SHY10086332/lightguard-hardware/演示视频拍摄脚本_硬件版_完整.md

# 演示视频拍摄脚本 · 硬件版（完整分镜）

> 目标：**真实 MP4、3~5 分钟、≤300 MB、1920×1080**。
> 赛事明确**不要**纯 PPT 翻页 / 静态模拟画面 / 只讲概念的宣传片 —— 画面必须是**真机真跑**。
>
> 本脚本取代早先的简版（`演示视频拍摄脚本.md` 保留作历史记录）。
> 拍摄前先按 `硬件演示系统/现场演示检查单.md` 把设备过一遍。

---

## 〇、先定三个数（照这个录，事后不用返工）

| 项 | 建议值 | 说明 |
|---|---|---|
| 分辨率 / 帧率 | **1920×1080 / 25~30 fps** | 与已有软件视频一致（1920×1080/25） |
| 视频码率 | **8 Mbps**（H.264） | 4 分钟 ≈ 240 MB，安全落在 300 MB 内 |
| 音频 | **AAC 128 kbps**（旁白） | 有旁白更好懂；没条件就用字幕 |

**时长分配（总约 4 分 10 秒）**：

```
0:00 ─ 0:25  片头与全景（是什么）
0:25 ─ 1:05  接线讲解（灯带不能直连 GPIO、必须共地）
1:05 ─ 1:45  数据集生产线（打印标签 → 采集台自动裁切 → 记录表）
1:45 ─ 2:45  照度闭环（目标 300 lx → 9 秒收敛 → 扰动后自动恢复）
2:45 ─ 3:35  检测与反馈（合格品绿灯 / 缺陷品红灯+蜂鸣 / 差异图）
3:35 ─ 4:10  数据与结论 + 收尾
```

---

## 一、开拍前 15 分钟：准备单

### 1. 环境（最重要，写在最前面）

- [ ] **桌面清空**：把纸质材料、证件、成绩单、笔记全部收走 —— 镜头里绝不能出现个人信息
      （实测踩过：相机对着桌面时曾拍到过个人表格，**必须每次开拍前确认**）
- [ ] 电脑桌面整理干净：**关掉微信/QQ/网盘窗口**，浏览器**不要显示书签栏**
- [ ] 资源管理器窗口**不要出现在画面里**（里面有个人路径）
- [ ] 房间灯可以开着当补光，但**全程不要中途开关**（光照一变，检测基准就变了）

### 2. 设备与软件

- [ ] ESP32 插好（设备管理器出现 **CP200x / COM 口**），灯带 5V 适配器插好
- [ ] 先启动一次演示台确认能连上：
      `硬件演示系统\演示台\0_启动演示台.bat` → 点「自检」→ 全绿
- [ ] 参考图先设好（用 `标签打印_1_正常_normal.pdf` 打印并放好的那张合格品）
- [ ] 准备 2~3 张**缺陷纸**（断线 / 缺墨 / 污点 / 划痕 / 偏位，任选便于辨认的）
- [ ] 手机：横屏、1080p、**关闪光灯**、开飞行模式（避免来电打断）
- [ ] 录屏工具：**OBS**（免费、能同时录屏幕+摄像头）或 Win+G / Win+Alt+R
- [ ] 亮度设置：**25%**（相机不过曝区间），改完**等 10~15 秒**再拍第一张

### 3. 想清楚"要证明什么"

评委看的是**证据**，不是形容词。全片必须拍到这 8 个镜头（清单在下面第三节标了 ★）。

---

## 二、分镜表

### 片段 1｜片头与全景（0:00–0:25）

| 画面 | 操作 | 旁白（可照读） |
|---|---|---|
| 桌面全景：灯带 + ESP32 + BH1750 + 摄像头 + 电脑，镜头缓慢横移 | 无 | "这是一套给工业视觉质检用的硬件：它会**自己把光稳住**，再配一条**数据集生产线**，把采集、训练、检测串成闭环。" |
| 特写：亮起/熄灭的灯带 | 按 `LIGHT 0` → `LIGHT 25` | "灯带由 ESP32 的 PWM 控制，亮度可以精确到 1%。" |

★ 镜头 ①：灯带随命令变化（证明"真的可控"，不是摆拍）

### 片段 2｜接线讲解（0:25–1:05）

| 画面 | 操作 | 旁白 |
|---|---|---|
| 特写 BH1750 四根线 | 手指依次指 SCL→GPIO22、SDA→GPIO21、VCC→3V3、GND | "照度传感器走 I2C：SCL 接 22、SDA 接 21，**供电必须 3.3V**。" |
| 特写 MOS 模块 | 指 `IN+`、`IN-`、`OUT±` | "灯带**不能直接接 GPIO**，必须经 MOS 模块；ESP32 和灯带电源**必须共地**。" |
| 特写红绿 LED + 蜂鸣器 | 无 | "绿灯=合格、红灯=异常，异常还会短鸣一声。" |

★ 镜头 ②：串口回读（屏幕上显示 `PING` → `{"ok":true,"device":"LIGHTGUARD_ESP32"}`、`STATUS` 回照度）

### 片段 3｜数据集生产线（1:05–1:45）

| 画面 | 操作 | 旁白 |
|---|---|---|
| 打印好的 A4 标签纸（含 100mm 校验尺） | 拿尺子量一下页脚 | "标签 60×40 毫米，一页 18 个，页脚有 100 毫米校验尺，保证打印不被缩放。" |
| 采集台页面 | 双击 `05_数据集与标签设计\console\0_启动采集台.bat` | "采集台是我们自己写的独立小工具，不需要任何别的软件。" |
| **裁切预览图** | 按 Enter 采一次 → 鼠标划到预览图上 | "一帧里自动找出**完整**标签逐个裁成图片，被画面边缘裁掉的直接剔除；不同列亮度不同，可以只保留指定的列。" |
| `采集记录表.csv` | 打开 Excel/记事本 | "每张图都记着当时的**照度、亮度、时间**，数据可追溯。" |

★ 镜头 ③：裁切预览图（绿框=已保存、红框=已剔除，一眼看懂）
★ 镜头 ④：CSV 记录表（照度/亮度真实值）

### 片段 4｜照度闭环（1:45–2:45，全片重点）

| 画面 | 操作 | 旁白 |
|---|---|---|
| 演示台页面（左右分屏：左边相机、右边闭环面板） | 点「自检」→ 全绿 | "开拍前先自检：串口、照度、灯带、输出目录一次过。" |
| 目标填 `300`、容差 `20` → 点「开始稳光」 | 让曲线跑完（约 9 秒） | "设目标 300 勒克斯，上位机闭环开始工作：读照度 → 调亮度 → 再读，**9 秒收敛**。" |
| 曲线图特写 | 指着收敛点 | "实测从 25% 亮度起步、223 勒克斯，一步调到 31%、**283.3 勒克斯**，落在 ±20 容差内。" |
| **扰动演示**：用手遮一下灯带 / 手动把亮度改成 50% | 再点「开始稳光」 | "有人挡光、或者亮度被改乱了，它会**自动拉回目标照度** —— 这就是整套系统的稳光能力。" |

★ 镜头 ⑤：稳光曲线（黄虚线=目标，蓝线收敛）
★ 镜头 ⑥：扰动后自动恢复

**口径提醒（重要）**：上位机闭环是真机实测通过的（9.1 秒、283.3 lx）。
正式固件本身只提供 `LIGHT n` 手动调光，**闭环跑在上位机里** —— 就照实说，别说成"固件内置自动稳光"。

### 片段 5｜检测与反馈（2:45–3:35）

| 画面 | 操作 | 旁白 |
|---|---|---|
| 放**合格品** → 点「设为参考图」 | 页面提示"参考图已设置 709×472" | "先拿一张合格品当基准。" |
| 换**缺陷品** → 按 **Enter** | 页面出现 ⛔异常 + 差异图 | "换上有缺陷的标签，按回车 —— 系统判为**异常**，差异图直接标出**哪里不对**。" |
| **实物红灯特写** | 同时画面切到硬件 | "同时，硬件那侧**红灯亮起、蜂鸣器短鸣**。" |
| 换回合格品 → Enter | ✅正常 + 绿灯 | "换回合格品，判定为**正常**，绿灯亮。" |

★ 镜头 ⑦：红灯 + 蜂鸣（硬特写，务必拍到声音）
★ 镜头 ⑧：差异图（红色标出差异区域）

### 片段 6｜数据与结论 + 收尾（3:35–4:10）

| 画面 | 操作 | 旁白 |
|---|---|---|
| 验证记录页面滚动（实测数据表） | 无 | "所有结论都有原始记录：闭环 9 秒收敛；6 种缺陷图案 **6/6 判对**；PWM 从 1kHz 提到 8kHz 后，相机画面的频闪条纹从 8.8 灰阶降到 **0.5**。" |
| 安全说明特写（或字幕） | 关灯 | "固件默认亮度已改为 0%，**任何复位都不会自己亮灯**；收尾一律关灯。" |
| 结束卡（作品名 + 一句话） | 无 | "光稳智检 —— 让每一次检测，都在同一束光下。" |

---

## 三、拍摄技巧（能省掉一半返工）

1. **双机位最省事**：手机拍实物（横屏、固定位置），电脑用 **OBS** 录屏；
   剪辑时用**画中画**（屏幕 + 实物同框），评委一眼就能看懂"操作"和"硬件反应"是同步的。
2. **屏幕不要拍到反光**：屏幕亮度调高、别开闪光灯、斜 15° 拍。
3. **一次拍一段，别追求一条过**：每段拍 2 遍，剪辑挑好的。
4. **关键操作前停 2 秒**：比如点「开始稳光」之前停一下，方便剪辑时上字幕。
5. **声音**：旁白用手机贴近说，或事后配音；环境音（蜂鸣器）一定要收到。
6. **不要加速跳过等待**：等 10 秒收敛是**优点**，别加速掉；可以在字幕标"实时"。

---

## 四、剪辑与压缩

1. 用**剪映专业版**（免费）或 HandBrake（纯压缩）。
2. 字幕要点：给"照度 / 亮度 / 判定"这些数字**上字幕**，无声也能看懂。
3. 导出：**H.264 + AAC，1920×1080，8 Mbps** → 4 分钟约 240 MB。
4. 压缩核对（命令行核对时长与体积）：

```powershell
ffprobe -v error -show_entries format=duration,size,bit_rate -of default=nw=1 "光稳智检_硬件演示视频.mp4"
```

**必须落在这三个区间内**：时长 **180~300 秒**、大小 **≤300 MB**、分辨率 1920×1080。

---

## 五、匿名红线（逐条过一遍再交）

- [ ] 没有学校名称、校徽、指导教师姓名、成员姓名、学号、邮箱、报名编号
- [ ] 没有旧版含身份信息的 PPT / 旧比赛材料入镜
- [ ] 资源管理器窗口没有出现（里面可能带个人路径/文件名）
- [ ] 浏览器书签栏、收藏夹、天气定位没有入镜
- [ ] 微信 / QQ / 网盘等窗口没有入镜
- [ ] 文件名本身不含姓名/学号（建议就用 `光稳智检_硬件演示视频.mp4`）
- [ ] 视频属性/音轨里没有身份信息（导出后抽 3 帧看一眼、听 10 秒）

---

## 六、可以放心说的实测数字（有原始记录支撑）

| 说法 | 数据 | 记录位置 |
|---|---|---|
| 闭环收敛快 | 300±20 lx：25%→223.3 lx → 31%→**283.3 lx，9.1 秒** | 验证记录 §2.16.2 |
| 判定准确 | 6 种真实标签图案 **6/6 判对**，硬件指示每次跟随 | §2.16.3 / §2.17.1 |
| 频闪条纹已消除 | 行 σ 从 1 kHz 的 **8.85 → 0.50**（20%~35% 亮度） | §2.18 |
| 相机不过曝区间 | 20%~30%（纸面 215、对比度 170、过曝 0%） | §2.19.2 |
| 真机帧不误报 | 同场景两帧互比：差异 **0.000%**（阈值 0.25%） | §2.19.1 |
| 复位不会自己亮 | 固件默认亮度 **0%**，复位后回读 0% | §2.16.5 |

**不能说的**（会被追问）：
- ❌"固件内置自动稳光"（闭环在上位机）
- ❌"模型已经用自采数据训练完成"（训练要另做，说"数据生产线已就绪、训练流程已跑通"更准确）
- ❌"连续运行 30 分钟无异常"（除非真跑了那 30 分钟并留记录）
