SHY10086332/lightguard-hardware/硬件提交说明.md

# AIC AI+硬件提交说明

本目录是独立硬件演示材料，不修改已经提交的软件项目。

建议验收顺序：ESP32 Blink -> BH1750 测光 -> PWM 灯带 -> 摄像头采图 -> 软件检测 -> 红绿结果反馈。

云端不能控制本地 ESP32；硬件闭环应在本地电脑和纸箱检测箱中演示。

---

## 一、目录索引

| 位置 | 内容 | 状态 |
|---|---|---|
| `00_从采购到参赛_执行总表.md` | 从采购到参赛的执行总表 | 既有 |
| `01_ESP32固件/lightguard_esp32.ino` | **正式固件**：BH1750 + 灯带 + 红绿 RGB + 蜂鸣器，配合网页串口交互 | 既有 |
| `01_ESP32固件/固件说明.md` | 正式固件的引脚、串口、烧录说明 | 既有 |
| `01_ESP32固件/测试固件说明_硬件验证.md` | **新增**：五个验证固件的用途、编译结果、烧录方法、与正式固件的一致性约定 | 2026-10-04 |
| `01_ESP32固件/esp32_blink_test/` | **新增**：只验证板子本身（不接外设） | ✅ 已实测通过 |
| `01_ESP32固件/bh1750_test/` | **新增**：验证 BH1750 读照度（自带驱动 + I2C 扫描） | ✅ 已实测通过（见 §2.7） |
| `01_ESP32固件/light_pwm_test/` | **新增**：验证 PWM 调光，可切 BH1750 闭环 | ✅ 两种模式均编译通过，MODE=1 闭环已实测（见 §2.12） |
| `01_ESP32固件/indicator_test/` | **新增**：单独验证红绿指示与蜂鸣器（不接灯带/BH1750） | ✅ 已烧录实测通过（见 §2.11） |
| `01_ESP32固件/mos_polarity_probe/` | **新增**：MOS 模块 `IN±` 极性探针 | 已编译，**尚未动用**（T-202 仍待测） |
| `01_ESP32固件/flash_manual.ps1` | **新增**：一条命令完成"编译 + 等你按 BOOT + 烧录" | ✅ 预检实测通过 |
| `02_硬件安装与接线/硬件安装一步一步.md` | 安装步骤 | 既有 |
| `02_硬件安装与接线/安装现场核对单.md` | 现场核对单 | 既有 |
| `02_硬件安装与接线/接线图.md` | **新增**：BH1750 / MOS 模块 + 灯带 / RGB + 蜂鸣器 的接线图与安全事项 | 2026-10-04 |
| `02_硬件安装与接线/引脚表.md` | **新增**：引脚分配实测表 + 禁用引脚 + PWM 参数对照 | 2026-10-04 |
| `02_硬件安装与接线/接线速查卡_一页版.md` | **新增**：打印版一页速查（引脚/接线/烧录三步/上电顺序/红线/排错表） | 2026-10-06 |
| `03_采购清单/最低成本采购清单_标签质检纸箱版.md` | 采购清单 | 既有 |
| `04_硬件验证记录/hardware-test-log.md` | **新增**：逐项硬件测试记录（含 esptool 识别、四个镜像 Hash 校验、串口原始日志） | 2026-10-04 |
| `04_硬件验证记录/README.md` | **新增**：硬件调试库总说明（目录结构、测试顺序、环境、踩坑记录） | 2026-10-04 |
| `05_数据集与标签设计/数据集采集说明.md` | **新增**：数据集采集材料清单、一致性要求、采集流程、数量与划分建议 | 2026-10-07 |
| `05_数据集与标签设计/make_labels.ps1` | **新增**：标签图案生成器（正常 + 5 种缺陷，60×40mm，A4 打印页 18 个/页） | 2026-10-07 |
| `05_数据集与标签设计/capture_dataset.ps1` | **新增**：数据集自动采集脚本（固定亮度 → 等照度稳定 → 抓帧 → 自动命名 → 记录照度到 CSV） | 2026-10-07 |
| `05_数据集与标签设计/labels/` `print/` | **新增**：6 种标签图案 PNG + 6 张 A4 打印页（含裁切标记与 100mm 校验尺；单张标签 60mm × 40mm） | 2026-10-07 |
| `05_数据集与标签设计/*.bat` | **新增**：8 个一键脚本（1 个自检 + 6 个按类别采集 + 1 个网页采集） | 2026-10-08 |
| `05_数据集与标签设计/web/` | **新增**：网页采集小工具（本地 Node 服务 + 浏览器页面，实时预览、照度稳定判断、自动写 CSV） | 2026-10-08 |
| `05_数据集与标签设计/console/` | **新增**：**独立数据集采集台**（自带网页：相机预览 + 6 类计数 + 照度稳定判断 + 撤销 + 导出 zip；照度取服务端串口真值，退出自动关灯；**不依赖任何已有软件**） | 2026-10-08 ✅ 接口自测 12/12 |
| `05_数据集与标签设计/app_module/` | **新增**：把采集能力接进光稳智检软件的**增量模块**（后端 `dataset_manager.py` + 前端 `dataset.js` + 一键接入脚本 `apply_to_app.py` + `接入方案.md`；共用 `console\dataset_manager.py`） | 2026-10-08 ✅ 副本实测 12/12 |
| `硬件演示系统/演示台/` | **新增**：**上位机演示软件**（一个页面跑完闭环：自动稳光照度 → 拍照 → 判定 → 串口发 RESULT → 硬件绿灯/红灯+蜂鸣；含稳光曲线、差异图、判定记录 CSV；判定模块有独立自测）。同目录还有三个配套工具：`calibrate_lux.py`（照度标定并出报告，自动判断与相机不过曝区间是否冲突）、`light_off.py`（应急关灯，回读硬件确认）、`banding_check.py`（频闪条纹复测） | 2026-10-09 ✅ 真机联调通过（闭环 9.1s 收敛；6 种标签 6/6 判对且硬件指示跟随） |
| `硬件演示系统/现场演示检查单.md` | **新增**：一页版检查单（接线 → 上电 → 软件启动 → 演示四步 → 安全红线 → 故障速查），打印后逐项打勾 | 2026-10-09 |
| `硬件演示系统/最小硬件版_搭建与演示.md` | 最小硬件版的搭建与演示 | 既有 |
| `演示视频拍摄脚本.md` | 演示视频分镜与旁白脚本 | 既有 |

## 二、当前硬件验证进度（实测）

> 口径说明：下表只写**确实做过并留有记录**的项。闭环相关结论的适用范围单独标注，避免把验证固件的实测结果写成正式固件的功能。

| 验收项 | 结论 | 证据 |
|---|---|---|
| ESP32 能被电脑识别（COM 端口） | ✅ COM5 / Silicon Labs CP210x | `04_硬件验证记录/hardware-test-log.md` §2.1 |
| 芯片识别 | ✅ ESP32-D0WD-V3 rev v3.1，双核 240MHz，Flash 4MB | §2.2 |
| Blink 上传成功 | ✅ 四个镜像全部 `Hash of data verified` | §2.4 |
| 板载 LED 固定周期闪烁 | ✅ 500ms，串口同步 5 秒 10 行 | §2.5 |
| BH1750 能读照度 | ✅ I2C 0x23 识别成功，0～约1442 lx 动态响应正常 | §2.7 |
| PWM 能调节灯带 | ✅ 亮度随验证固件 `light_pwm_test` 的 `BRIGHTNESS:` 变化，人工目视确认。**正式固件 `lightguard_esp32.ino` 尚未编译/烧录**，其 `LIGHT n` 通道未实测 | §2.10 |
| 红绿指示逻辑正常 | ✅ 绿灯=正常 / 红灯=异常 / 异常短鸣，`indicator_test` 三轮自检人工确认 | §2.11 |
| MOS 模块 `IN±` 极性 | ⏳ **待测**（T-202）：已按 `IN+` 接 GPIO25、`IN-` 接 GND 完成 PWM 与闭环测试，但极性本身未用探针独立确认 | §2.10、§3 T-202 |
| **照度闭环（自动稳光）** | ✅ **算法实测通过**：三段阶跃平滑收敛，稳态偏差 ≤1.4%（见 §2.12）。⚠️ **验收点 900±30 lx 需先标定**：lx/% 斜率取决于 BH1750 相对灯带/样品的位置，记录里出现过 39（§2.10）与 28.5（§2.12）两个值，验收前须把 BH1750 固定到最终箱内标签位后复测一次并记录「达到 900 lx 所需亮度 %」。⚠️ **适用范围**：实测是在验证固件 `light_pwm_test`（MODE=1）与上位机 Python 控制器上完成的，**实测目标为 901 / 1472 / 2327 lx，未在 900 lx 验收点复测**；**正式固件 `lightguard_esp32.ino` 目前只支持手动 `LIGHT n`，闭环尚未移植进固件** | §2.12 |
| 8 kHz PWM 抑制频闪条纹 | ✅ **已复测（2026-10-09）**：同一方法（画面最平坦区域的逐行灰度均值标准差）下，行 σ 从 1 kHz 时的 8.85/8.78/8.80 降到 **0.50~0.94**（20%~35% 亮度），条纹基本消失。附带实测：这套光照下**相机自动曝光收敛慢**，≤10% 亮度不可靠（同一档位在不同等待时间下结论相反），**建议 20%~30%，且改完亮度等 5~7 秒再拍第一张** | §2.13、§2.18 |
| 摄像头稳定采图 / 纸箱光照均匀 / 自采标签数据 | ⏳ 未完成 | 见 §3 任务清单未勾选项 |
| **抓拍图片规范化** | ✅ 采集到的图片统一转成真 JPEG（RGB/质量 92）并**清除 EXIF 元数据**（数据集要交付，不该带相机元信息）；回归验证落盘文件 `format=JPEG`、`EXIF字段数=0` | §2.17.1 |
| **数据集采集台（独立版，推荐）** | ✅ **接口自测 12/12 通过**：首页 + 7 条接口（状态/采集/撤销/亮度/最近/缩略图/导出）、缺硬件时优雅降级（照度记空、`/api/light` 明确报 409 而不是假装成功）、目录穿越被拦、退出自动 `LIGHT 0` 关灯。**只依赖自己的固件串口协议，不含、也不改任何已有软件** | §2.15 |
| **采集台接入软件（增量模块，可选）** | ✅ **副本实测 12/12 通过**：4 条 `/api/dataset/*` 接口（状态/采集/撤销/导出）、页面注入、原有 4 条接口**零回归**；照度取服务端硬件状态。**原软件目录全程未被改动**（已验证：无 `_backup_*`、无新增文件），模块+一键脚本+回滚方案已备好 | §2.14 |
| **上位机演示软件 + 真机闭环联调** | ✅ **真机通过**：① 照度闭环 目标 300±20 lx → 25%(223.3) → 31%(**283.3 lx**)，**9.1 秒收敛**；② 6 种真实标签图案 **6/6 判对**，且每次判定都**通过串口改变了硬件的红绿指示**（不是只在网页显示）；③ 参数校验 400、未接硬件 409；④ 真机标定 **9.77 lx/每 1%**，据此发现 **900 lx 需 94.1% 亮度 → 与相机不过曝冲突**（见 §2.16.1，需决策）；⑤ 实测发现"强杀进程不关灯 → 板子复位回到默认 45%"的安全隐患，**已把固件默认亮度改为 0 并烧录验证**（复位后回读 `brightness=0`、照度 0 lx；调光回归 25%→222.5 lx 正常） | §2.16 |

## 三、三条最容易踩的坑（现场演示前务必确认）

1. **烧录必须手动按 BOOT**：这块板没有自动下载电路。
   手势＝**按住 BOOT 不放 → 按一下 EN/RST → 松开 BOOT**；或用 `flash_manual.ps1`（它会等你按）。
2. **灯带不能直接接 GPIO**，必须经 MOS 模块/驱动模块；且 **ESP32 的 GND 必须与灯带 5V 电源共地**。
3. **RGB 红绿不要接反**：`GPIO26 = 绿 = 正常`，`GPIO27 = 红 = 异常`。
   正式固件默认亮度已改为 **0%**（2026-10-09 烧录验证）：复位 / 拔插 USB 不会再自己亮。
   但**调光仍需显式发 `LIGHT n`**，收尾建议发一次 `LIGHT 0`（上位机软件连上与退出时都会自动发）。
