SHY10086332/lightguard-hardware/00_从采购到参赛_执行总表.md

# 光稳智检盒：从采购到参赛执行总表

本文件是整个项目的唯一总入口。按编号依次完成即可，不需要同时阅读所有代码文件。

## 0. 已确定的最终方案

| 项目 | 最终决定 |
|---|---|
| 参赛方向 | AI + 硬件创新 |
| 检测对象 | 普通A4纸上打印的工业标签 |
| AI方法 | 自采数据训练 `printed_label` PatchCore异常检测模型 |
| 硬件创新点 | BH1750测光 + ESP32闭环调节灯带 + AI检测 + RGB红绿状态/蜂鸣器反馈 |
| 结构 | 定制五层瓦楞纸箱暗箱，不做3D打印 |
| 标签尺寸 | A4纸上的 60mm × 40mm 标签（见 `05_数据集与标签设计/`），核心检测区约 50mm × 32mm |
| 纸箱内部尺寸 | 深490mm × 宽365mm × 高315mm（使用时确认是内尺寸） |
| 目标照度 | **900 ± 30 lux**（原定 450±20 lux 与实测标定不符，已按实测数据调整）。⚠️ **验收前必须先标定一次**：亮度→照度的斜率主要取决于 **BH1750 相对灯带/样品的位置**，不是灯带本身；记录里已出现 39 lx/%（§2.10，传感器贴近灯带）与 28.5 lx/%（§2.12，另一摆放位置）两个不同值。因此固定 BH1750 到**最终箱内标签位**后，从 10% 到 40% 逐档记录照度，把「达到 900 lx 所需亮度 %」写进日志，再据此确定验收点（按 28.5 或 39 lx/% 计算，900 lx 都落在 20%~35% 这一「相机不过曝」区间内，因此与数据集采集光照、演示光照可以做到三合一） |
| 不采用 | 机械臂、麦轮小车、传送带、树莓派、COCO、原 `bottle` 模型作为正式参赛模型 |

内置15类MVTec权重只用于软件功能演示。正式参赛实验统一选择自己训练生成的 `printed_label` 类别。

## 1. 文件阅读顺序

1. `00_从采购到参赛_执行总表.md`：先看本页，掌握全过程；
2. `最低成本采购清单_标签质检纸箱版.md`：照表搜索和下单；
3. `硬件安装一步一步.md`：照步骤摆放硬件、接线和验收；
4. `安装现场核对单.md`：安装时逐项打勾，核对安全停点和验收项目；
5. `最小硬件版_搭建与演示.md`：查看功能说明和比赛演示流程；
6. `firmware/README.md`：给ESP32烧录固件；
7. `自定义标签模型训练说明.md`：拍照、分数据集、训练和测试模型；
8. `05_数据集与标签设计/数据集采集说明.md`：标签图案生成、打印、按类别自动采集与照度记录；
9. `01_ESP32固件/测试固件说明_硬件验证.md`：五个验证固件的用途与烧录方法；
10. `README.md`：软件功能、启动方式和API技术说明（在 `aic AI+软件/软件项目源代码/01_可运行系统/` 下）。

## 2. 分阶段执行

### 阶段A：硬件未到货

- 双击 `start.bat`；
- 浏览器打开 `http://localhost:5051`；
- 使用“模拟硬件”演示测光、调光、检测和状态反馈流程；
- 双击 `01_创建标签数据目录.bat`，提前创建数据目录；
- 设计并打印 60mm × 40mm 的正常标签和不同缺陷版本（见 `05_数据集与标签设计/`）。

模拟模式用于开发和讲解，不能作为实物实验结果。

### 阶段B：下单

完整型号、搜索词、预算和避坑说明见：

```text
最低成本采购清单_标签质检纸箱版.md
```

预计核心硬件预算112～243元；已有摄像头、数据线或电源可以复用。价格以下单当天为准。

### 阶段C：纸箱搭建

1. 不在纸箱侧壁开进料口，先保留箱体完整；
2. 先量内尺寸，再把A4纸按定位线放在箱底：297mm边沿365mm方向，210mm边沿490mm方向；
3. 摄像头先用硬纸板临时固定在标签中心上方，量镜头最前端到纸面的距离并检查清晰度；箱高315mm时可从约305～315mm试拍，再按实物画面微调；
4. 摄像头画面、灯带和照度都验证且合盖画面确认后，才开最小镜头孔。USB插头通常不穿纸箱；若要开走线孔，按线缆粗细决定，不预设10mm；
5. 1米灯带先沿左右侧壁和后侧试摆，不要先裁剪或永久粘贴；先检查画面反光，再做标签中心与四角照度测量；
6. 需要柔光时才加描图纸，并与发光面留出间隙；
7. BH1750放在标签平面附近，感光面朝上、不被遮挡；ESP32、面包板、MOS模块和电源放箱外；
8. 用胶带封漏光处，并用定位线固定A4纸位置。

### 阶段D：接线与烧录

首次安装按 `硬件安装一步一步.md` 操作，并用 `安装现场核对单.md` 逐项确认；`firmware/README.md` 只用于烧录和查固件引脚，不可用旧总览中的示意去猜MOS端子。全部为5V/3.3V低压连接，不拆接220V市电。

第一次上电顺序：

1. 只连接ESP32和BH1750，验证照度读取；
2. 确认MOS准确型号、模块接线图、3.3V PWM兼容性、隔离/共地方式、灯带功率和适配器极性；任何一项不清楚时不接灯带5V电源；
3. 灯带电源保持拔掉，在网页切换到“ESP32串口实物”，选择正确COM口并连接，确认页面显示已连上实物；
4. 在实物模式把亮度设为0%并确认页面显示0%。**（2026-10-09 更新：正式固件默认亮度已由 45% 改为 0% 并烧录验证——复位后回读亮度 0%，重启 / 拔插 USB / 重连 COM 口都不会再让灯带自己亮，原先「每次重启前拔掉灯带 5V」的做法不再是必需。）**
5. 桌面短测正常后，先断开5V适配器，再断开ESP32 USB，将灯带临时放入箱内。复测前重新连接ESP32串口、设0%，再插5V适配器，然后做中心及四角照度检查和摄像头反光检查；
6. 全部位置确定后再开最小孔、固定硬件。RGB模块和有源蜂鸣器最后接，第一轮可以暂时不装；
7. 连续点亮10分钟并有人看管，确认灯带、纸箱和导线没有明显发热。

### 阶段E：制作和采集标签

建议准备：

- 正常标签：完整文字、边框和条码；
- 缺陷标签：缺字、遮挡、污损、断线、褪色、边缘缺损；
- 每种缺陷至少准备一张独立纸样；
- 相机、纸箱、灯光、焦距和A4定位线固定后再开始正式拍摄。

数据建议：

| 数据目录 | 内容 | 建议数量 |
|---|---|---:|
| `train/good` | 正常训练图 | ≥30张 |
| `calibration/good` | 独立正常校准图 | ≥6张 |
| `calibration/defect` | 独立缺陷校准图 | ≥6张 |
| `test/good` | 独立正常测试图 | ≥6张 |
| `test/defect` | 独立缺陷测试图 | ≥6张 |

同一照片不能进入两个目录；测试用实体纸样也不能出现在训练或校准环节。

### 阶段F：训练自己的模型

1. 双击 `01_创建标签数据目录.bat`；
2. 按目录放入照片；
3. 双击 `02_训练并测试标签模型.bat`；
4. 确认生成 `weights/printed_label.pth`；
5. 确认生成 `training_reports/printed_label_日期_时间.json`；
6. 重新启动网页并选择 `printed_label`。

这一步生成的是自己的正常特征记忆库和自己的校准阈值，不使用原来的 `bottle.pth`。

### 阶段G：对照实验

使用同一批独立测试纸样进行两组实验。纸箱合盖后外部遮光通常不会显著改变箱内照度；应使用可重复的灯带亮度变化或箱内遮光扰动，并在变化后再采图：

| 组别 | 灯光方式 | 其他条件 |
|---|---|---|
| 对照组 | 固定灯光亮度 | 相机、样品、纸箱不变 |
| 实验组 | BH1750 + ESP32自动稳光 | 相机、样品、纸箱不变 |

记录正常误报、缺陷漏报、F1、检测时间和照度波动。不要把训练集结果当成最终实验结果。

### 阶段H：参赛证据

建议至少保存：

- 纸箱内部结构照片；
- ESP32、BH1750、灯带和摄像头近照；
- 正常样品、各类缺陷样品照片；
- 自定义模型训练报告JSON；
- 对照组与自动稳光组结果表；
- 网页正常/异常检测截图；
- 一段 3～5 分钟（赛事要求时长）连续演示视频：展示灯带亮度扰动和照度恢复→正常检测→缺陷检测→红灯/蜂鸣器。

是否必须提交视频以当届比赛通知为准，但提前录制连续实物视频可以证明作品确实运行。

## 3. 最终完成标准

- [ ] 使用真实ESP32，而不是只用模拟模式；
- [ ] BH1750照度随遮挡和灯光变化；
- [ ] 自动稳光能进入目标照度 ±30 lux（验收点 900 lx，需先按最终 BH1750 位置标定「达到 900 lx 所需亮度 %」）；
- [ ] 相机连续采图20次无黑屏和严重虚焦；
- [ ] 生成自己的 `printed_label.pth`；
- [ ] 正常标签能够点亮绿灯；
- [ ] 缺陷标签能够点亮红灯并触发蜂鸣器；
- [ ] 有独立测试集结果，不只展示训练样本；
- [ ] 有固定灯光与自动稳光对照实验；
- [ ] 有照片、截图、报告和实物演示视频；
- [ ] 连续运行30分钟无程序崩溃和异常发热。

## 4. 当前暂时不做

- 自动传送和抓取；
- 多角度机械结构；
- 标签四角自动透视校正；
- PCB设计；
- 3D打印外壳；
- 手机App或云端平台；
- 多种实物类别同时训练。

这些功能不影响完成最基本、可参赛的AI+硬件作品。
