SHY10086332/lightguard-hardware/演示视频拍摄脚本.md

# AIC AI+硬件演示视频拍摄脚本

目标：真实 MP4，建议 3--5 分钟，最终文件不超过 300 MB。

> 📋 **拍摄前后照《现场演示检查单.md》走一遍**（接线 → 上电 → 软件启动 → 演示四步 → 安全红线 → 故障速查）。
> 里面每项都写了"看到什么才算对"，比临时回忆可靠。
> 上位机演示软件在 `硬件演示系统/演示台/`：双击 `0_启动演示台.bat`，
> 流程是「放合格品 → 设为参考图 → 稳光 → 换待检品按 Enter → 页面与硬件同时给出结果」。

## 镜头顺序

1. 0:00--0:20：展示纸箱检测箱、摄像头、灯带、ESP32、BH1750 和电脑。
2. 0:20--0:45：展示 ESP32、BH1750、灯带和电源接线，说明 5V 灯带电源与 ESP32 共地、灯带不能直接接 GPIO。
   （本方案 MOS 模块的控制端是 `IN+` / `IN-`，`IN-` 就是控制地，必须与 ESP32 的 GND 连通；换用其他型号时按其自身接线图接线。）
3. 0:45--1:10：打开软件，选择检测类别，加载模型。
4. 1:10--1:45：放入正常样本，点击采图/上传，展示“正常”结果、异常分数和热力图。
5. 1:45--2:30：更换缺陷样本，展示“异常”结果、热力图和叠加图。
6. 2:30--3:00：展示照度读数、灯光亮度调整和红绿状态反馈。
7. 3:00--3:35：上传多张图片，展示批量检测、历史记录和 CSV 导出。
8. 3:35--4:00：展示代码目录、硬件目录和项目在线展示页。

## 拍摄要求

- 画面必须来自真实运行过程，不能用 PPT 渲染图代替；
- 屏幕文字要清晰，避免拍到账号密码、学号等隐私；
- **不要拍到旧版（含学校名/指导教师/成员）的 PPT 或旧比赛材料**，也不要把资源管理器窗口里带个人路径或旧项目命名的文件名拍进去；
- **不要拍到个人浏览器的书签栏、收藏夹、天气定位等个人信息**；录制前清一个干净的桌面或用全屏软件窗口；
- 如果 ESP32 尚未完成实物闭环，应明确说“当前为模拟硬件模式”，不要声称已经实物联动；
- **口径提醒**：照度闭环目前只在验证固件 `light_pwm_test` 与上位机 Python 控制器上实测通过，正式固件 `lightguard_esp32.ino` 只有手动 `LIGHT n`。视频里不要说“固件已自动稳光”，可以说“闭环算法已在验证固件和上位机上跑通，固件版本还在移植”；
- 如果检测对象是瓶盖/标签，必须使用自采样本和自训练模型，不能把 `bottle` 类别称为瓶盖模型。
