SHY10086332/lightguard-hardware/演示视频拍摄脚本_软件版.md

# 演示视频拍摄脚本 · 软件版（光稳智检）

> 适用：**AIC 演示视频**与 **iCAN 演示视频**都可照这个拍/复用。
> 硬性要求：**MP4、3~5 分钟、≤300 MB、真实运行**，不许纯 PPT 或静态模拟。
>
> ⚠️ 现状：**已有一条成品** `光稳智检_演示视频.mp4`（**18.39 MB / 4 分 47 秒 / 1920×1080 / H.264+AAC**，
> 片头/页脚/资源管理器/浏览器 4 处已遮蔽，独立抽帧核验通过）。
> **如果赛事允许沿用，这条可以继续用**；本脚本用于「需要重拍」或「要补录硬件联动段落」的情况。
>
> ★ 注意：软件本体是**已提交的作品**，拍视频只做"运行与演示"，**不要改它的代码**。

---

## 〇、规格与时长分配（约 4 分 10 秒）

| 项 | 建议 |
|---|---|
| 分辨率 / 帧率 | 1920×1080 / 25 fps（与已有成品一致） |
| 码率 / 音频 | 8 Mbps H.264 + AAC 128 kbps |
| 录制方式 | **OBS 全屏录屏**（不要用手机拍屏幕，字会糊） |

```
0:00 ─ 0:25  片头：这是什么、解决什么问题
0:25 ─ 0:55  主界面导览 + 选择检测类别
0:55 ─ 2:00  核心演示：拍照检测（合格品 → 缺陷品）
2:00 ─ 2:40  批量检测 / 对比模式
2:40 ─ 3:20  历史记录与导出报告（CSV）
3:20 ─ 3:50  硬件联动（可选但很加分）
3:50 ─ 4:10  数据集与自定义训练闭环 + 收尾
```

---

## 一、开拍前准备

- [ ] **先启动软件**：双击 `01_可运行系统\start.bat`（或 `光稳智检_iCAN演示启动.bat`），
      浏览器打开 `http://localhost:5051`，确认标题与端口都对
- [ ] **模型就绪**：确认 `pretrained/` 与 `weights/` 到位、能正常选类别（否则检测会报 503）
- [ ] **素材就绪**：合格品图片 + 3~5 张缺陷图片（用真机拍的自采样本，别用公开数据集图）
- [ ] **桌面整理**：关掉微信/QQ/网盘；浏览器**隐藏书签栏**；资源管理器窗口不要入镜
- [ ] **窗口**：浏览器全屏（F11），分辨率 1920×1080，缩放 100%
- [ ] **录屏**：OBS 只录浏览器窗口（不要录整个桌面，避免带出其它窗口）
- [ ] 手机横屏备用（要拍"硬件灯/蜂鸣器"时用）

**匿名红线**：不出现学校名/Logo/指导教师/成员姓名/学号/邮箱/个人账号；桌面与路径里
不要出现个人姓名；文件名用 `光稳智检_演示视频.mp4`。

---

## 二、分镜表

### 片段 1｜片头（0:00–0:25）

| 画面 | 旁白 |
|---|---|
| 软件首页整体（卡片布局：模式 / 类别 / 硬件 / 上传 / 参数 / 统计） | "光稳智检是一套**工业视觉质检系统**：用正常样本训练，不需要收集缺陷样本，就能把异常挑出来。" |

### 片段 2｜主界面与类别（0:25–0:55）

| 画面 | 操作 | 旁白 |
|---|---|---|
| 类别卡片（多类别网格） | 鼠标点开一个类别 | "系统支持多类别切换，也可以自己采数据训练新类别（后面演示）。" |
| 硬件卡片（串口状态） | 鼠标移上去 | "硬件面板可以连接本地 ESP32：读照度、控灯带、把判定结果送到红绿指示灯。" |

### 片段 3｜核心：拍照检测（0:55–2:00）★ 全片重点

| 画面 | 操作 | 旁白 |
|---|---|---|
| 相机预览打开 | 点「打开摄像头」 | "现场用 USB 摄像头直接拍，不需要先存文件。" |
| 放**合格品** → 点「拍照检测」 | 结果：**正常**，显示异常分数与阈值 | "合格品判为正常，页面给出异常分数和判定阈值。" |
| 换**缺陷品** → 点「拍照检测」 | 结果：**异常**，显示热力图/差异区域 | "换上有缺陷的样品，判为**异常**，并标出异常区域。" |
| 阈值滑块 | 拖动阈值 → 重新检测 | "阈值可以现场调整，适应不同的严格程度。" |

★ 必须拍到的证据镜头：
1. 结果区同时出现**分数、阈值、判定**三个数（不是只有一个"通过"）
2. 缺陷位置可视化（热力图/差异图）
3. 同一张图在阈值调整前后判定变化

### 片段 4｜批量与对比（2:00–2:40）

| 画面 | 操作 | 旁白 |
|---|---|---|
| 选中多张图片 → 批量检测 | 出现逐张结果列表 | "产线上更多是批量场景，一次可以过一批图。" |
| 对比模式 | 两张图并排 + 分数对比 | "对比模式把正常和缺陷放在一起，方便看模型的分辨能力。" |

### 片段 5｜历史与报告（2:40–3:20）

| 画面 | 操作 | 旁白 |
|---|---|---|
| 历史记录列表 | 滚动 | "每次检测都留档：时间、类别、分数、判定。" |
| 点「导出报告」 | 打开 CSV（Excel 里中文不乱码） | "一键导出 CSV 报告，Excel 直接打开，可以作为质检台账。" |

### 片段 6｜硬件联动（3:20–3:50，有硬件就一定拍）

| 画面 | 操作 | 旁白 |
|---|---|---|
| 硬件卡片：选串口 → 点连接 | 状态变成"ESP32 实物" | "当硬件在线时，系统还能控制检测环境的光照。" |
| 设亮度 / 目标照度 | 实物灯带随之变化（画中画） | "目标照度下发到硬件，灯带自动调到对应亮度 —— **光照稳定，判定才稳定**。" |
| 拍一张 → 结果灯 | 合格绿灯 / 缺陷红灯+蜂鸣（画中画） | "判定结果直接送到硬件的红绿灯和蜂鸣器，现场不用看屏幕也知道结果。" |

### 片段 7｜数据集与自定义训练（3:50–4:10）

| 画面 | 操作 | 旁白 |
|---|---|---|
| 采集台页面（一图一标签） | 按一次采集 | "样本用我们自研的采集台采集：自动裁出每个标签，照度亮度逐张记录。" |
| 训练脚本执行 | 命令行跑 `train_custom_category.py`（可加速） | "采完的数据可以直接训练成新类别，形成**采集 → 训练 → 检测**的闭环。" |
| 结束卡 | 无 | "光稳智检：稳定光照，稳定判定。" |

---

## 三、录制与剪辑要点

1. **录屏用 OBS**：只录浏览器窗口；鼠标移动放慢、别乱晃。
2. **一段一录**：每个片段单独录，出错就重录那一段。
3. **数字要看得清**：录制前把浏览器缩放设为 100%，必要时后期**放大局部**（剪映"缩放/关键帧"）。
4. **等待要保留**：检测耗时、训练耗时**可以加速**，但要在画面角上标"×4 加速"。
5. **导出**：H.264 + AAC、1920×1080、8 Mbps；4 分钟约 240 MB。
6. **核对**：

```powershell
ffprobe -v error -show_entries format=duration,size -of default=nw=1 "光稳智检_演示视频.mp4"
```

必须满足 **180~300 秒**、**≤300 MB**。

---

## 四、可以放心说的（有实测/记录支撑）

- 本地 Flask + PyTorch 运行，**推理在本机**，不上传图片到云端
- 支持多类别、阈值可调、批量检测、历史留档、CSV 报告导出
- 用**正常样本**即可训练（PatchCore 异常检测思路），不需要缺陷样本
- 硬件侧：ESP32 读照度、控灯带、红绿指示 + 蜂鸣；闭环稳光 300±20 lx **9.1 秒收敛**
- 数据集侧：自研采集台 **一图一标签自动裁切**，逐张记录照度/亮度

## 五、不要说的

- ❌ 不要说"已部署在公网/在线可用"（除非真部署了并给出地址）
- ❌ 不要说"准确率 99%+"（除非有留出集上的真实评测数据）
- ❌ 不要把"硬件闭环"说成软件的一部分（是两套系统联动，口径要分清）
- ❌ 不要说"完全无人值守"（现场仍是本机运行 + 人工放样）
