SHY10086332/lightguard-hardware/05_数据集与标签设计/labels/label_faint.png

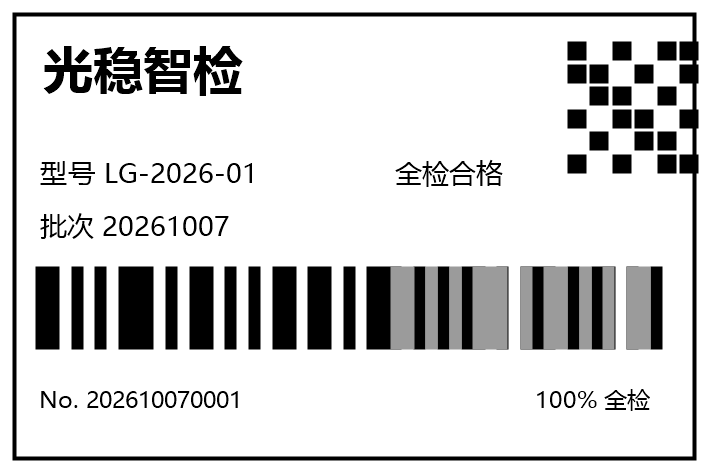
05_数据集与标签设计/labels/label_faint.png
