SHY10086332/lightguard-hardware/03_采购清单/最低成本采购清单_标签质检纸箱版.md

# 最低成本采购清单：A4标签质检纸箱版

适用方案：现有Windows电脑运行AI，定制瓦楞纸箱作为暗箱，普通A4纸打印正常/缺陷标签，ESP32完成测光、自动调光和结果反馈。

执行顺序和全项目文件导航见 `00_从采购到参赛_执行总表.md`。

不购买机械臂、麦轮小车、树莓派、显示屏、传送带和3D打印件。

## 一、下单顺序

建议只分三单，尽量减少运费：

1. 电子模块店：ESP32、BH1750、MOSFET模块、面包板、杜邦线、RGB灯模块、蜂鸣器；
2. 灯带店：5V灯带、5V电源、DC5521母座带线；
3. 摄像头店：UVC USB摄像头。
4. 纸箱店：按内尺寸定制五层瓦楞纸箱。

A4纸、胶带和描图纸尽量使用现有物品。

## 二、第一阶段必买清单

| 硬件 | 数量 | 作用 | 直接复制的搜索词 | 下单前必须确认 | 是否依赖精确尺寸 | 参考预算 |
|---|---:|---|---|---|---|---:|
| ESP32-WROOM-32开发板 | 1 | 读取照度、调节灯光、控制指示灯和蜂鸣器，并用USB串口和电脑通信 | `ESP32-WROOM-32 30针 Type-C CH340 已焊排针` | 成品开发板；已焊排针；Type-C口；能USB下载程序；不是单独裸模组 | 否 | 18～35元 |
| GY-302 BH1750照度模块 | 1 | 测量标签表面的实际照度，给自动稳光提供反馈 | `GY-302 BH1750 光照度传感器 已焊排针` | 已焊排针；3.3V可用；I2C接口 | 否 | 6～12元 |
| 720P UVC USB摄像头 | 1 | 从纸箱顶部拍摄标签，供AI检测；不必为1080P额外付费 | 低成本候选：`720P 55度3.8MM无畸变带外壳` | 确认是Windows可用UVC USB设备、支持彩色、附USB线；确认约30～32cm可清晰对焦；实际分辨率以电脑预览为准 | 先临时安装试拍，标签清晰完整后才定孔位 | 30～70元 |
| 5V COB中性光灯带 | 1米 | 给纸箱内部提供均匀、可调的检测光照 | 商品选项：`【5V 8mm宽 300灯/米】1米COB灯带 高亮款`，颜色选`中性光` | 单色两线；询问实际功率/电流；优先Ra≥90、约4000～5000K；无控制器；可裁剪；最好已焊红黑线 | 宽8mm，无需其他精确尺寸 | 12～25元 |
| PWM MOS管驱动模块 | 1 | ESP32不能直接带动灯带，此模块负责控制5V灯带亮度 | 首选：`XY-MOS 大功率MOS管模块 PWM调光调速 5-36V 3.3V触发`；也可：`YYMOS-1 PWM信号放大 MOS管驱动模块` | XY-MOS：负载5～36V、信号3.3～20V；YYMOS-1：输入输出3.3～24V、频率≤1kHz、负载≤3A | 否 | 5～15元 |
| 5V 4A稳压电源适配器 | 1 | 单独给灯带供电，避免烧坏ESP32 | `5V4A 电源适配器 DC5521` | 输出必须是5V直流；插头5.5×2.1mm；正规成品适配器 | 否 | 20～35元 |
| DC5521母座带红黑线 | 1 | 把5V适配器直接接到PWM模块，无需转接端子和焊接 | `DC5521 5.5×2.1 母座带线 红黑线 5A 30cm` | 必须是母座；内径2.1mm；红正黑负；线长约20～30cm；额定电流≥3A，优先5A款 | 否 | 3～8元 |
| 红黑并线/电源线 | 0或1米 | 仅在灯带自带线太短时延长灯带输出线 | `红黑并线 0.5平方 多股软线 1米` | 可先不买；灯带已焊线且长度够时不需要 | 按实际距离裁剪 | 0～8元 |
| MB-102 830孔面包板 | 1 | 固定和整理ESP32、传感器及指示模块的无焊接线路 | 商品选项：`MB-102 面包板165×55×10mm（1个）` | 只买单独面包板；不带电源模块、电池盒和双公头USB线 | 否 | 7～15元 |
| 杜邦线三种套装 | 1套 | 连接ESP32、BH1750和各小模块 | `杜邦线 公对公 公对母 母对母 20cm 三种套装` | 三种接头都包含；20cm左右 | 否 | 8～15元 |
| Type-C USB数据线 | 1 | 给ESP32供电、下载固件并和电脑串口通信 | `Type-C USB 数据线 可传数据 1米` | 必须能传数据，不能是仅充电线 | 否 | 5～10元 |
| 定制五层瓦楞纸箱 | 1 | 形成固定尺寸的遮光检测舱 | `五层瓦楞纸箱 定制尺寸 少量定做` | 向商家明确要求**内尺寸**490×365×315mm（深×宽×高）；普通开槽箱、无印刷；不要预开摄像头孔 | 是 | 按商家报价 |

第一阶段预算约 **112～243元**。同店合并购买、已有USB数据线或摄像头时还可以继续下降。价格只作预算上限参考，以下单当天为准。

## 三、建议同时购买，但可以稍后补

| 硬件/材料 | 数量 | 作用 | 搜索词 | 要确认的条件 | 参考预算 |
|---|---:|---|---|---|---:|
| 共阴RGB全彩LED模块 | 1 | 绿灯表示正常、红灯表示异常；蓝色通道第一版不用 | `RGB全彩LED模块 共阴 4针 自带限流电阻` | 公共端标`－`或GND；引脚包含R/G/B；自带限流电阻；已焊4针排针；用户所选5050共阴模块可用 | 2～6元 |
| 有源蜂鸣器模块 | 1 | 检测到缺陷时发出短提示音 | `有源蜂鸣器模块 3.3V 5V 高电平触发 S8050 三针` | 必须是有源、高电平触发；三针VCC/GND/IN；优先带三极管驱动 | 3～8元 |
| 描图纸/烘焙纸 | 1张 | 放在灯带前柔化光线，减少A4纸局部过曝 | `A4 描图纸 半透明` | 普通半透明、耐轻微发热即可 | 0～8元 |
| 黑色胶带、双面胶、扎带 | 各1 | 固定相机、灯带、传感器并封住纸箱漏光处 | `黑色布基胶带 强力双面胶 尼龙扎带` | 优先使用家里现有材料 | 0～20元 |
| A4普通打印纸 | 10～20张 | 制作正常标签和不同缺陷标签，用于自定义模型训练和测试 | `A4打印纸 70g 80g` | 普通纸即可，不需要250g卡纸 | 0～10元 |
| USB延长线 | 0或1 | 摄像头自带线够不到电脑时使用 | `USB2.0 延长线 1.5米` | 先量距离，够长就不买 | 0～15元 |

## 四、不要购买的东西

- 不买机械臂、麦轮底盘、传送带、树莓派、液晶屏和旋转平台；
- 不买3D打印外壳或相机架，先用纸箱、胶带和扎带；
- 不买`IRF520 MOSFET模块`，它不适合ESP32的3.3V控制信号；
- 不买标明负载输入最低为6V的隔离式D4184/LR7843模块，因为本方案灯带为5V；
- 不买12V或24V灯带，避免又要更换电源和驱动；
- 不买RGB、WS2812或带遥控器的灯带，本项目只需要单色两线白光灯带；
- 不买自动对焦会议摄像头作为首选，固定检测距离下手动调焦更稳定；
- 不买只有ESP32-WROOM-32字样的裸芯片模组，必须买带USB口的开发板；
- 不买未焊排针的BH1750，否则需要自己焊接。

## 五、需要的尺寸与不需要的尺寸

### 购买前必须知道

1. **纸箱内部深、宽、高**：实物按深490mm × 宽365mm × 高315mm使用；下单时必须向商家确认报的是内尺寸，而不是外尺寸。
2. **标签有效检测区尺寸**：A4上打印 60mm × 40mm 标签图案（见 `05_数据集与标签设计/`）；正式拍摄时相机只需完整覆盖该标签，A4纸本身不必完整进入画面。
3. **摄像头工作距离**：纸箱内高约315mm时，箱顶附近安装的镜头距纸面接近300mm。先临时安装实测；如果标签太小或失焦，再将摄像头下移。不要仅按商品标题中的55°推算视野。
4. **纸箱到电脑的距离**：决定摄像头线和ESP32数据线是否需要延长。
5. **纸箱开孔**：先完成临时试拍和走线，再开最小镜头孔。USB线孔按插头/线身实际大小决定；侧壁不切大孔。

### 现在不需要知道

- ESP32电路板精确长宽；
- BH1750电路板孔距；
- MOSFET模块安装孔距；
- RGB灯和蜂鸣器外壳尺寸。

原因是第一版全部用面包板、胶带和扎带固定，不打孔、不做PCB，也不做3D打印。只有以后要设计正式外壳时，才需要每个模块的精确尺寸和孔位。

## 六、给卖家的确认话术

购买MOSFET模块前发送：

```text
我要用ESP32的3.3V PWM信号，控制5V单色两线COB灯带，长度0.5～1米并调节亮度。
请提供准确型号和端子接线图，并确认模块支持5V负载、3.3V逻辑PWM、**8kHz** PWM（本项目实测用 8kHz：1kHz 会让相机画面出现频闪条纹）；PWM占空比增加时负载变亮。请说明输入有效电平、控制地接法、是否与负载侧隔离、额定电流，以及电源和灯带各接哪些端子。
```

部分XY-MOS商品会使用 `DC+ / DC- / OUT+ / OUT-` 和 `PWM（或TRIG）/ GND` 这些标识，但这不是所有MOS模块的通用端子顺序。不要只按外观、颜色或商品名接线；下单前让卖家确认准确型号、端子图、3.3V输入兼容性、PWM频率与有效电平、是否隔离/是否需要共地、5V负载接法及额定电流。到货后仍要核对实物丝印和接线图。

`YYMOS-1` 只有在卖家确认其具体版本满足以上参数时才可使用。若额定电流为3A，按余量选择灯带，并依据铭牌功率/电流核算；不同批次端子排列可能不同，接线前必须根据商品接线图或板上丝印核对输入、供电和负载端，不能只按端子位置猜测。

购买摄像头前发送：

```text
我要在Windows电脑的浏览器中使用，准备购买“720P 55度3.8MM无畸变带外壳”。请确认它是USB UVC摄像头，Windows免驱可用，附USB线，并能在约30～32厘米对标签对焦；也请说明实际支持的分辨率和焦距是否可调。
```

购买灯带前发送：

```text
我要购买“5V、8mm宽、300灯/米、1米高亮款”，颜色选中性光。
请问实际功率是多少W/米或电流是多少A/米？色温和显色指数是多少？
请确认是单色两线、可裁剪、不带控制器，最好发已焊红黑电源线的版本。
```

若卖家回复不超过10W/米（或不超过2A/米），可以使用完整1米；若超过10W/米，第一轮只使用0.5米，避免YYMOS-1长期接近3A上限。

## 七、到货后需要提供的信息

为了画最终纸箱内部布局，只需要拍照或测量下面四项：

1. 纸箱内部深 × 宽 × 高；
2. 摄像头正面、侧面以及支架照片；
3. 摄像头USB线长度；
4. A4标签实际打印区域的宽 × 高。

不需要使用游标卡尺，普通直尺测量到5mm精度就足够。
