SHY10086332/lightguard-hardware/05_数据集与标签设计/print/A4_brokenline.png

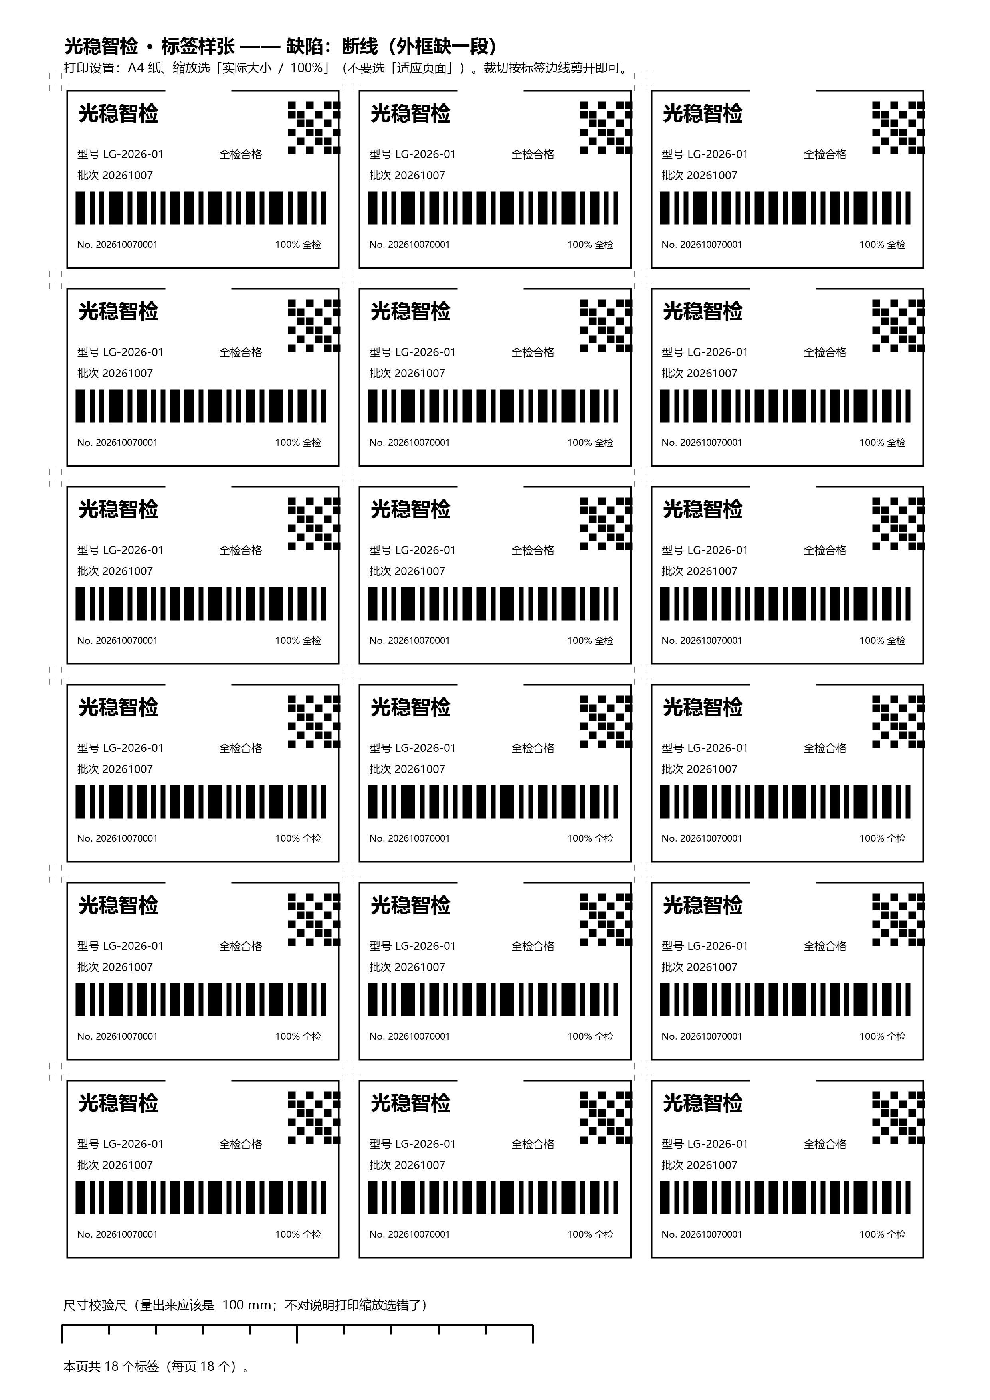
05_数据集与标签设计/print/A4_brokenline.png
