SHY10086332/lightguard-hardware/04_硬件验证记录/hardware-test-log.md

# 硬件测试记录（hardware-test-log）

记录每一次硬件验证的**原始证据**。规则：只写实测结果，不写"应该可以"。
每完成一项，在下面的总表和"最终任务清单"里同步打勾。

---

## 0. 环境基线（已固定，勿随意变更）

| 项 | 值 |
|---|---|
| 日期 | 2026-10-04 |
| 电脑 | Windows，Arduino IDE 2.x（`D:\arduino IDE\Arduino IDE.exe`） |
| 开发板支持包 | `esp32:esp32@3.3.12`（2026-10-04 安装，19 个压缩包 SHA-256 全通过） |
| 板型 / FQBN | ESP32 Dev Module / `esp32:esp32:esp32` |
| 串口 | COM5（Silicon Labs CP210x，VID_10C4 PID_EA60） |
| 速率 | 115200 8N1 |
| 命令行工具 | `arduino-cli 1.5.1`（IDE 自带）、`esptool v5.3.1` |

---

## 1. 测试总表

| 编号 | 项目 | 时间 | 结果 | 证据位置 |
|---|---|---|---|---|
| T-001 | 电脑识别串口设备 | 2026-10-04 23:10 | ✅ 通过 | §2.1 |
| T-002 | 芯片识别（esptool） | 2026-10-04 23:25 | ✅ 通过 | §2.2 |
| T-003 | 编译 esp32_blink_test | 2026-10-04 23:29 | ✅ 通过 | §2.3 |
| T-004 | 烧录 esp32_blink_test | 2026-10-04 23:32 | ✅ 通过 | §2.4 |
| T-005 | 板载 LED 闪烁 + 串口输出 | 2026-10-04 23:32 | ✅ 通过 | §2.5 |
| T-006 | 编译验证固件（仓库自检） | 2026-10-04 23:5x | ✅ 通过（当时 3 个，现共 5 个） | §2.6 |
| T-101 | BH1750 读照度 | 2026-10-05 00:26 | ✅ 通过 | §2.7 |
| T-201 | MOS 模块实物识别 | 2026-10-05 00:40 | ✅ 通过 | §2.8 |
| T-201b | 电源与灯带参数核对（电流核算） | 2026-10-06 16:20 | ✅ 通过 | §2.9 |
| T-202 | MOS 输入极性（IN+/IN-）确认 | — | ⏳ 待测 | 用 `mos_polarity_probe` |
| T-203 | PWM 固定阶梯调光 | 2026-10-06 21:0x | ✅ 通过（人工目视确认灯带随 PWM 变化） | §2.10 |
| T-204 | PWM 照度闭环 | 2026-10-07 13:2x | ✅ 通过（稳态偏差 ≤1.4%） | §2.12 |
| T-301 | 红/绿指示逻辑（含蜂鸣器） | 2026-10-07 13:1x | ✅ 通过 | §2.11 |
| T-401 | 摄像头稳定采图 | — | ⬜ 待测 | 接入主系统阶段 |
| T-402 | 纸箱光照均匀性 | — | ⬜ 待测 | — |
| T-403 | 正常样本判正常 | — | ⬜ 待测 | — |
| T-404 | 缺陷样本判异常 | — | ⬜ 待测 | — |
| T-405 | 串口协议跑通（Flask ↔ ESP32） | — | ⬜ 待测 | — |
| T-406 | 串口断开时降级为模拟演示 | — | ⬜ 待测 | — |

---

## 2. 详细记录

### 2.1 T-001 电脑识别串口设备 ✅

```
设备管理器 → 端口(COM 和 LPT)
Silicon Labs CP210x USB to UART Bridge (COM5)
InstanceId: USB\VID_10C4&PID_EA60\0001    Status: OK
```

结论：CP2102 驱动已装好，无需再装驱动。
（若换用 CH340 的板子，需另装 CH340 驱动，现象是"端口"里什么都不出现或出现带感叹号的未知设备。）

### 2.2 T-002 芯片识别 ✅

命令：
```
esptool --port COM5 --before no-reset flash-id
```
输出（关键行）：
```
Detecting chip type... ESP32
Chip type:          ESP32-D0WD-V3 (revision v3.1)
Features:           Wi-Fi, BT, Dual Core + LP Core, 240MHz, Vref calibration in eFuse
Crystal frequency:  40MHz
MAC:                20:9b:a9:97:b1:d4
Detected flash size: 4MB
Flash voltage set by a strapping pin: 3.3V
```

**同时确认了一个重要事实**：使用默认复位方式时报
`A fatal error occurred: Failed to connect to Espressif device: Wrong boot mode detected (0x13)!`
→ 说明**本板自动下载电路没有把 GPIO0 接到 DTR**，所以必须手动按 BOOT。
这不是板子坏了，是硬件设计如此（廉价 38pin 板常见）。

### 2.3 T-003 编译 ✅

```
Sketch uses 275112 bytes (20%) of program storage space. Maximum is 1310720 bytes.
Global variables use 22172 bytes (6%) of dynamic memory, leaving 305508 bytes for local variables.
```

首次编译曾失败：
```
Error during build: exec: "cmd": executable file not found in %PATH%
```
**根因**：系统机器级 PATH 与用户级 PATH 都缺少 `C:\Windows\System32`（用 `reg query` 原始读取确认）。
**处置**：已把 `C:\Windows\System32;C:\Windows;C:\Windows\System32\Wbem;C:\Windows\System32\WindowsPowerShell\v1.0;`
加回 HKLM 的 Path 最前面，并广播 `WM_SETTINGCHANGE`。
原值已导出备份为 `path-backup-machine-20261004-233654.txt`（存放在本机调试工作目录内，不入提交）。
**复验**：用"注册表重建的全新 PATH"再编译一次，`EXITCODE=0`。

### 2.4 T-004 烧录 ✅

手势：按住 BOOT → 按一下 EN → 松开 BOOT → 立即用 `--before no-reset` 烧录。
```
Writing 'bootloader.bin'  at 0x00001000 ... Wrote 24992 bytes ... Hash of data verified.
Writing 'partitions.bin'  at 0x00008000 ... Wrote 3072 bytes  ... Hash of data verified.
Writing 'boot_app0.bin'   at 0x0000e000 ... Wrote 8192 bytes  ... Hash of data verified.
Writing 'BlinkTest.ino.bin' at 0x00010000 ... Wrote 275264 bytes (518.5 kbit/s) ... Hash of data verified.
Hard resetting via RTS pin...
```
四个镜像全部 `Hash of data verified`（即写回校验通过）。

### 2.5 T-005 运行验证 ✅

串口 115200 抓到的完整启动日志：
```
ets Jul 29 2019 12:21:46
rst:0x1 (POWERON_RESET),boot:0x13 (SPI_FAST_FLASH_BOOT)
configsip: 0, SPIWP:0xee
mode:DIO, clock div:1
load:0x3fff0030,len:4876
entry 0x400805b4

===== ESP32 Blink Test =====
chip model : ESP32-D0WD-V3  rev 301  cores 2
cpu freq   : 240 MHz
flash size : 4 MB
sdk version: v5.5.5
mac        : D4:B1:97:A9:9B:20
led pin    : GPIO2
============================
LED ON
LED OFF
LED ON
LED OFF
```

交叉验证：固件读到的 MAC `D4:B1:97:A9:9B:20` 与 esptool 读到的 `20:9b:a9:97:b1:d4` 为同一串（字节序相反），互相印证读值真实。
节奏验证：5 秒内 10 行输出 = 每 500ms 一条，与 `BLINK_INTERVAL_MS` 一致。

### 2.6 T-006 仓库固件自检 ✅

下表三个固件在 `esp32:esp32:esp32` 下编译通过，且**不依赖任何第三方库**（BH1750 驱动自带），可直接在干净环境编译（`indicator_test`、`mos_polarity_probe` 见 `测试固件说明_硬件验证.md`）：

| 固件 | 编译结果 | Flash 占用 |
|---|---|---|
| `esp32_blink_test` | EXITCODE=0 | 275132 B (20%)（§2.3 原始日志里同一次构建写作 275112 B，两次记录略有差异，不影响结论） |
| `bh1750_test` | EXITCODE=0 | 297364 B (22%) |
| `light_pwm_test` (MODE=0 固定阶梯) | EXITCODE=0 | 307571 B (23%) |
| `light_pwm_test` (MODE=1 照度闭环) | EXITCODE=0 | 315239 B (24%) |

MODEL=1 比 MODE=0 多 7.6KB，说明 BH1750 闭环代码确实被编译进去了（不是空分支）。
切换模式命令：
```powershell
& $cli --config-file $cfg compile --fqbn esp32:esp32:esp32 `
      --build-property build.extra_flags=-DMODE=1 `
      ".\light_pwm_test"   # 本包内的固件目录（相对 01_ESP32固件 的位置）
```
（记住：**改完 MODE 必须重新编译+烧录**，板上跑的还是旧固件。）

---

### 2.7 T-101 BH1750 照度读取 ✅

**接线**（断电后接的，共 4 根线，`ADDR` 悬空）：

| BH1750 | ESP32 | 说明 |
|---|---|---|
| VCC | 3V3 | **不是 5V** |
| GND | GND | 共地 |
| SDA | GPIO21 | I2C 数据 |
| SCL | GPIO22 | I2C 时钟 |

**烧录**：`flash_manual.ps1 -Sketch .\bh1750_test`，按一次 BOOT 后自动完成，4 个镜像全部 `Hash of data verified`。

**启动日志（节选）**：
```
===== BH1750 Test =====
# chip ESP32-D0WD-V3   flash 4 MB   sdk v5.5.5
# i2c  SDA=GPIO21  SCL=GPIO22
# I2C 扫描结果：
#   发现设备 0x23
# 找到 BH1750：0x23
# 初始化完成，开始输出 LUX:<照度>
=======================
```

**90 秒连续采样（每 500ms 一条，原始时间戳）**：

| 时间 | 动作 | 读数 |
|---|---|---|
| 00:26:20 → 00:26:42 | 静置（室内光） | 稳定 **53.3 lx**（raw=64） |
| 00:26:43 → 00:26:55 | 手掌完全捂住感光面 | 跌到 **0.0 lx**（raw=64 → 11 → 0） |
| 00:26:56 → 00:27:15 | 手机手电筒照射 | 峰值 **raw=1730**，按固件公式 `照度 = raw / 1.2` 换算为 **1441.7 lx** |
| 00:27:16 → 00:27:26 | 移开手电 | 回落 184.2 → 104.2 → 51.7 lx |
| 00:27:27 → 00:27:50 | 静置 | 稳定回 **50.8 lx** |

结论：
- 动态范围约 **0 ~ 1441.7 lx（约 27 倍）**，捂住/照光/移开三个动作都有明确且平滑的响应，无跳变、无卡死、无掉线；
- 读数噪声小（静置时同一 raw 值连续出现数十次），说明 I2C 通信质量良好（杜邦线长度短、上拉正常）；
- **通过标准满足**：遮住读数明显变化 ✅
- ⚠️ 原记录把该峰值写作 1549.2 lx，与同行的 raw=1730 不自洽（1730 / 1.2 = 1441.7），已按固件实际公式更正。

**这一步同时确认的事**：`bh1750_test` 不需要任何第三方库即可编译运行（驱动自带），
所以后续若只想快速验证硬件，不必先去库管理器装 `BH1750 by Christopher Laws`
（该库仅正式固件 `lightguard_esp32.ino` 需要）。

---

### 2.8 T-201 MOS 模块实物识别 ✅

**背景**：需要确认手上这块模块是不是"能被 ESP32 控制的 MOS 管 PWM 驱动模块"，
而不是"手调 PWM 调速器"（后者有旋钮、没有信号输入脚，ESP32 无法控制）。

**核对方式**：用户实拍照片（正/反面各数张）+ 用户现场读丝印。

**核对结论** ✅：

| 核对项 | 结果 |
|---|---|
| 外形 | 蓝色 PCB，**4 位螺丝端子 + 2 位螺丝端子**，**无旋钮** |
| 型号字样 | 板上可读丝印含 `MOS-1`（与清单中 XY-MOS 同类） |
| 4 位端子丝印 | `DC-` `DC+` `OUT+` `OUT-`（电源进 / 负载出） |
| 2 位端子丝印 | `IN+` `IN-`（信号输入） |
| 判断 | **是标准 MOS 管 PWM 驱动模块，可用** ✅（不是旋钮调速器） |

**注意点**：`IN+` / `IN-` 的丝印是竖排小字，用户报告的顺序与照片读数存在差异，
**因此不靠"看丝印"决定极性**，改用 `mos_polarity_probe` 固件做电气自检（见 T-202）。
把 GPIO25 接到 `IN-` 等于短路到地，可能烧引脚，这一步不做赌博式判断。

**兼容性核对**：模块资料标称输入 5~36V、信号 3.3~20V、PWM 0~20kHz；
正式固件用 8kHz/8 位、本验证库同样 8kHz/8 位（2026-10-07 由 1kHz 提高）—— 均在允许范围内。

---

### 2.9 T-201b 电源与灯带参数核对（插 5V 之前的必做核算）✅

**依据**：用户提供的两张实物照片（适配器铭牌、灯带包装标签），2026-10-06 核对。

| 器件 | 照片上的原始信息 | 结论 |
|---|---|---|
| 5V 适配器 | `MODEL:0540`；`INPUT:AC100-240V 50/60Hz`；**`OUTPUT: 5V ⎓ 4A`**；极性符号为**中心正、外负** | 5V 4A = **20W**，满足需求 |
| 5V 灯带 | `【5V 8mm 300灯/米】1米COB灯带[高亮款] 中性光`，1 件 | 单色两线 COB，1m，中性光 ≈4000~4500K（适合检测箱） |

**电流核算**：

```
适配器可供 ：5V × 4A = 20 W
灯带预估   ：5V COB 300灯/米 高亮款 ≈ 8~12 W/米 → 1.6~2.4 A（标签未标功率，取同类经验值）
余量       ：4 A ÷ 2.4 A ≈ 1.67 倍   → 1 米整条可直接使用，无需截短
MOS 模块   ：双 MOS 设计，Rds(on) 按 10~20mΩ 估，2~3A 时发热约 0.1 W，无需散热片
```

**判定**：✅ 允许接入整条 1 米灯带。**灯带实际功率是唯一未知量**，因此首次点亮用现象兜底：

| 现象 | 含义 | 处理 |
|---|---|---|
| 模块只是温热 | 正常 | 继续 |
| 模块明显烫手（不能持续接触 3 秒） | 电流偏大 | 拔 5V，限制到 ≤50% 亮度，或只接半条 |
| 亮度忽明忽暗 / ESP32 复位 | 电源被拉低 | 拔 5V，减小负载 |

**已预判的已知现象**：5V 灯带 1 米存在**沿线压降**（远端偏暗），属正常物理现象；
若影响"5 点照度均匀性"测量，可改为**灯带两端同时接电源线**（双端供电）。

**待确认项**：DC5521 母座带线的**红/黑线对应关系**（一般红=中心正极、黑=外负）。
接反会让 MOS 模块承受反压，因此第一次上电前应目视确认线色与适配器极性符号一致。

---

### 2.10 T-203 / T-204 灯带 PWM 与照度闭环（2026-10-06 实测）

**接线**：`适配器红→DC+`、`黑→DC-`、`灯带红→OUT+`、`黑→OUT-`、`GPIO25→IN+`、`GND→IN-`（DC5512 母座线接适配器）。
固件：`light_pwm_test`，PWM **8 kHz / 8 位**（2026-10-07 由 1 kHz 提高），GPIO25。

#### T-203 固定阶梯调光 ✅

安全启动固件启动后亮度锁定 0%，发送命令后逐档升亮，**人工目视确认灯带亮度随 PWM 同步变化**
（`BRIGHTNESS:` 值在 0/25/50/75/100 之间变化，灯带对应变亮变暗）。
→ **PWM 调光链路（GPIO25 → MOS 模块 → 灯带）验证通过**，且 5V 适配器与 ESP32 共地成立（通过 `IN-`）。

#### T-204 照度闭环 🔶 链路通、参数需标定

**实测数据（命令 `T:0`+`A` 使亮度压到 0，`B:100` 手动锁定全亮）**：

| 状态 | BH1750 读数 | 亮度 |
|---|---|---|
| 环境（灯带灭） | **49.2 lx** | 0% |
| 灯带全亮 | **3951.7 lx** | 100% |
| 灯带贡献 | **+3902.5 lx** | — |

→ **BH1750 能看到灯带的光，灯带能被 PWM 控制，闭环的两个方向都通。**

**发现的问题（真实工程问题，已定位并修正）**：闭环进入后亮度在 0% 与 100% 之间**来回跳**：

```
BRIGHTNESS: 100 → 0 → 0 → 0 → 100 → 0 → 0 → 0 → 100 → 88 → 85 → 84 → 17 → 0 …
```

**根因**：按第一次标定的增益估算 —— `3902.5 lx ÷ 100% ≈ 39 lx / 每 1% 亮度`。
> ⚠️ 这只是**第一次标定**（传感器贴近灯带）；后来在 §2.12 重新标定为 0% → 45.8 lx、100% → 2897.5 lx（≈28.5 lx/%）。
> **lx/% 与被 BH1750 摆放位置强相关**，标定与验收请以最终箱内位置的复测值为准。
原固件比例系数 `KP = 0.06` ⇒ **环路增益 = 0.06 × 39 = 2.34 ≫ 1**，比例控制必然振荡。

**修正（第一轮迭代）**：

| 参数 | 原值 | 新值 | 理由 |
|---|---|---|---|
| `KP` | 0.06 | **0.0025** | 按第一次标定 39 lx/% 环路增益 ≈0.098（按最终标定 28.5 lx/% 约 0.071） |
| `MAX_STEP_PCT` | 无（一步到位） | **8** | 单周期最多调 8%，防止猛冲 |
| 死区 | 无 | 第一轮 **15 lx** → 最终改为**按目标值的 ±2%**（代码中为 `DEADBAND_PCT = 2.0f`） | 进入死区就不动，消除目标点附近抖动 |

另外修正了 MODE 1 的一个交互问题：手动亮度（`B:n`）下也应持续读照度（只读不调），
方便后续标定；MODE 0 下 `B:n` 仍不触发阶梯。

**下一步（已完成）**：烧入标定后的固件后复测，三段阶跃平滑收敛、稳态偏差 ≤1.4%，结论见 §2.12。
抗干扰（遮挡/手电筒扰动）测试**尚未开展**。

---

### 2.11 T-301 红绿指示灯 + 有源蜂鸣器 ✅（2026-10-07）

**固件**：`indicator_test`（引脚与正式固件 **相同**：GPIO26 绿 / GPIO27 红 / GPIO32 蜂鸣器）。
⚠️ **串口协议并不相同**：`PING` 回 `LIGHTGUARD_INDICATOR`，只实现自检 `T` 与 `RESULT`，
不实现 `STATUS` / `LIGHT`，返回也不是正式固件的完整 JSON → **不能用网页直接连它**，只用于离线点亮验证。

**接线**（全部经面包板电源轨做总线）：

| 模块 | 引脚 | 接到 |
|---|---|---|
| 共阴 RGB | `G` | ESP32 **GPIO26**（绿灯 = 正常） |
| 共阴 RGB | `R` | ESP32 **GPIO27**（红灯 = 异常） |
| 共阴 RGB | `-` | 面包板**蓝轨**（GND 总线） |
| 共阴 RGB | `B` | 不接 |
| 有源蜂鸣器 | `VCC` | 面包板**红轨**（3V3 总线） |
| 有源蜂鸣器 | `GND` | 面包板**蓝轨** |
| 有源蜂鸣器 | `IN` | ESP32 **GPIO32** |

**面包板用法**：只借左下段的两条电源轨做总线 —— 蓝轨（GND）汇 5 根线，红轨（3V3）汇 3 根线；
中间孔区不使用；ESP32 / BH1750 / MOS 模块都平放在桌面，不插板。
（注意：MB-102 的电源轨**中间断开**，上下段互不相通，所有线必须插在同一段内。）

**测试方法**：连发 3 次自检命令 `T`，每轮为「绿灯 2s → 红灯 2s + 短鸣 → 全灭」。
串口 3 次均返回 `{"ok":true,"selftest":"done"}`；**人工目视 + 听觉确认**三轮表现完全一致且正确。

**结论**：
- 三个输出通道（GPIO26 / GPIO27 / GPIO32）全部工作正常 ✅
- 实物模块为**共阴型**、蜂鸣器为**有源型（高电平触发）**，与代码假设一致，无需改参数
- 安全启动有效：上电时全部熄灭，只有收到命令才动作

---

### 2.12 T-204 照度闭环 ✅（2026-10-07，参数两轮迭代后通过）

**目标**：让 ESP32 自动调节灯带亮度，把 BH1750 处的照度**锁定在设定值**上
（这是"照度稳定后再拍照"的前提，也是自动适应不同箱体/环境光的关键）。

**被控对象实测**：灯带 0% → 45.8 lx（环境），100% → 2897.5 lx
⇒ 增益约 **28.5 lx / 每 1% 亮度**（不同摆放位置会变，所以参数要按量级标定）。

> ⚠️ **口径提醒（验收必读）**：这个 28.5 lx/% 只对**这一次的 BH1750 摆放位置**成立。
> §2.10 第一次标定时传感器贴近灯带，测得约 **39 lx/%**；传感器离得越远，斜率越小。
> 因此 **lx/% 是"位置相关"的**：验收/采集前必须把 BH1750 固定到**最终箱内标签位**再标定一次，
> 记录「达到 900 lx 所需亮度 %」，再据此确定验收点（900±30 lx）。

**参数迭代过程（真实调试记录）**：

| 版本 | 参数 | 现象 | 诊断 |
|---|---|---|---|
| v1 | `KP=0.06` | 亮度在 **0%↔100% 来回跳** | 环路增益 = 0.06×39 ≈ **2.34 ≫ 1**，比例控制必然振荡 |
| v2 | `KP=0.0025` + 单步限幅 8% + 死区 15 lx | 振荡消失、轨迹平滑，但**停在离目标 20% 处** | 误差 326 lx × 0.0025 = **0.8%，被 `(int)` 取整成 0** → 永远差一口气 |
| **v3（通过）** | `KP=0.0025` + **最小步长 1%** + 死区 **±2%×目标** | 平滑收敛，稳态偏差 ≤1.4% | — |

**v3 实测（三段目标阶跃）**：

| 段 | 目标 | 亮度轨迹（节选） | 末态照度 | 偏差 |
|---|---|---|---|---|
| 1 | 1472 lx | 97 → 94 → 91 → … → 54 → 53 | **1473.3 lx** | **+1 lx（+0.1%）** |
| 2 | 2327 lx | 55 → 57 → 58 → … → 83 → 84 | **2293.3 lx** | **−34 lx（−1.4%）** |
| 3 | 901 lx | 81 → 78 → 75 → … → 33 → 32 | **888.3 lx** | **−13 lx（−1.4%）** |

**结论**：
- ✅ 三段阶跃全部平滑收敛，**无振荡、无过冲**，稳态偏差 ≤1.4%
- ✅ 精度上限由亮度分辨率决定：1% 亮度 ≈ 28.5 lx，因此闭环精度约 **±1~2%**，与正式固件的 1% 亮度分辨率同量级
- ✅ 死区按目标值百分比自适应，换到箱内不同照度区间仍适用
- ⚠️ **适用范围**：以上结论来自**验证固件 `light_pwm_test`（MODE=1）与上位机 Python 控制器**；
  正式固件 `lightguard_esp32.ino` 目前只支持手动 `LIGHT n`，闭环尚未移植（见下面"给正式固件的建议"）
- ⚠️ 实测目标为 901 / 1472 / 2327 lx，**未在 900 lx 验收点复测**

**给正式固件的建议**：把这套参数（`KP=0.0025`、最小步长 1%、死区 ±2%）移植到
`lightguard_esp32.ino`，替换目前"只能手动设亮度（`LIGHT n`）"的做法，
即可实现"照度稳定后再拍照"的自动稳光闭环。

---

### 2.13 T-501 相机画面 PWM 频闪条纹与消除（2026-10-07）

**现象**：接入 USB 摄像头（`USB Camera`，VID_0BDA/PID_D576）后，画面出现**固定横向明暗条纹**。

**量化方法**：从画面纸面空白区取 80px 宽竖条 → 逐行求灰度均值 → 统计波动标准差
（`ffmpeg -vf "crop=80:1080:950:0,format=gray" -f rawvideo` + PowerShell 逐行统计）。

| 帧 | 平均灰度 | 最暗 | 最亮 | **波动标准差** |
|---|---|---|---|---|
| b25-02 | 168.7 | 117.6 | 182.7 | **8.85** |
| b25-03 | 168.6 | 116.6 | 183.2 | **8.78** |
| b25-04 | 168.6 | 127.5 | 183.5 | **8.80** |

**三帧几乎相同** → 不是随机噪声，而是**固定相位图案**（相机曝光与 PWM 锁相），
符合"PWM 调光 × 卷帘快门"的频闪条纹特征；严重程度 ≈ 3.5% 满量程。

**根因**：灯带 PWM 为 **1 kHz**（周期 1 ms），画面较亮时相机选择**很短的曝光时间**，
卷帘快门逐行曝光 → 每行看到的 PWM 相位不同 → 固定横向条纹。

**修正**：PWM 频率 **1 kHz → 8 kHz**（`lightguard_esp32.ino` 与 `light_pwm_test` 同步修改）。
> ⚠️ **待复测**：上表三帧标准差（8.85 / 8.78 / 8.80）是**改频率之前**、1 kHz 下测得的数据。
> 改成 8 kHz 后**还没有重新采集逐帧数据**，"条纹幅度大幅下降"目前只是按原理推断，须在实机上复测后才能写结论。
原理：8 kHz 周期 125 µs，相机单行曝光跨越多个 PWM 周期被平均掉，条纹幅度大幅下降。
本模块标称 0~20 kHz，8 kHz 在允许范围内；**换用 ≤1 kHz 的模块须改回 1 kHz**。

**同步更新**：`固件说明.md`、`测试固件说明_硬件验证.md`、`引脚表.md`、`接线图.md`、`接线速查卡_一页版.md`。

**★ 工程约定**：**训练数据、测试数据、演示视频必须在同一套光照设置（同一 PWM 频率）下采集**，
否则模型输入分布不一致、准确率会下降。最终频率一经确定不要随意更改。

**同时确认的摄像头信息**：

| 项 | 值 |
|---|---|
| 设备名 | `USB Camera`（VID_0BDA / PID_D576），免驱 UVC |
| 实测分辨率 | 1920 × 1080 |
| 抓帧方式 | `ffmpeg -f dshow -i "video=USB Camera"`（本机已验证） |
| 25% 亮度成像 | **文字清晰可辨认**（能读出姓名、身份证号、手写内容、签字日期）✅ |
| 100% 亮度成像 | **过曝**，纸面一片白、文字被冲掉 ❌ |
| 结论 | 箱内工作亮度应取 **20%~35%**（≈300~600 lx）；100% 不可用 |

### 2.14 T-601 数据集采集台接入光稳智检（2026-10-08，离线副本实测）✅

**目的**：把"现场采集数据集"这一步做进现有 Flask 软件（形成 采集 → 训练 → 检测 → 报告 的闭环），
且**不能碰已经提交的检测逻辑**。

**方法（关键）**：不直接改原软件，而是把 `01_可运行系统` 整目录复制到一份临时副本
（与任何提交目录无关的独立文件夹），在副本上用 `apply_to_app.py` 应用改动，
把副本**真起服务**（`PORT=5098` 避开原端口），逐一打接口验证。原软件一次都没被写过。

**这一步抓出 3 个只看代码绝对发现不了的坑**：

| # | 问题 | 现象 | 根因 | 修正 |
|---|---|---|---|---|
| 1 | **插入点错了** | 改完访问 `/api/dataset/status` 返回 **404** | 代码追加在文件**最末尾**，而末尾在 `if __name__ == '__main__': app.run(...)` **之后**；`app.run()` 阻塞不返回 → 后面的模块级代码（含路由注册）**永远执行不到** | 必须插在 `if __name__ == '__main__':` **之前** |
| 2 | 控制台花符号崩 | 装完打印最后一行时抛 `UnicodeEncodeError: 'gbk' codec can't encode '\u2714'` | Windows 控制台默认 cp936，编不出 `✔ ⚠ ✗` | 输出改用 `[OK] [!] [x]`，并给 `print` 加编码兜底 |
| 3 | CSV 中英混排 | `normal` 行缺陷列写「无」（中文），`scratch` 行写 `scratch`（英文） | 代码里 `defect = cls`（英文 key） | 改成写中文标签（划痕/缺墨…），列内语言统一；「类别」列仍是英文 key（与目录名一致） |

**接口自测结果：12 项全通过**

| # | 测试 | 期望 | 实测 |
|---|---|---|---|
| 1 | `GET /api/dataset/status` | 6 个类别、各类计数 | ✅ `classes=6`，`per_class` 全 0 |
| 2 | 首页注入 | 页面含 `js/dataset.js` | ✅ HTTP 200，且 `js/main.js` 仍在 |
| 3 | `POST /api/dataset/capture` | 落盘 + 返回序号 | ✅ `faint_0001.jpg`，`lux=1328.3`、`亮度=45` |
| 4 | 图片落盘 | 文件存在 | ✅ `dataset\images\faint\faint_0001.jpg` |
| 5 | CSV 记录 | 中文缺陷名、照度、亮度 | ✅ `faint_0001.jpg,faint,缺墨,1328.3,45,...` |
| 6 | 类别隔离 | 换类从 `_0001` 起 | ✅ normal/scratch/stain 各自从 0001 |
| 7 | `POST delete_last` | 删文件 + 删 CSV 行 | ✅ `count=0`，磁盘与 CSV 同步减少 |
| 8 | 非法类别 | HTTP 400 | ✅ 400 |
| 9 | 缺图片 | HTTP 400 | ✅ `没有收到图片` |
| 10 | `GET export` | zip 含 images/ + CSV | ✅ 4 项条目完整 |
| 11 | **回归**：`/api/categories`、`/api/status`、`/api/hardware/status`、`/api/history` | 全部 200 | ✅ 4/4 |
| 12 | 幂等保护 | 重复运行脚本拒绝二次插入 | ✅ 退出码 2，不写任何文件 |

**照度来源验证**：接口返回的 `lux=1328.3 / 亮度=45` 来自服务端 `hardware_manager.status()`
（当时是 Mock 控制器），**不是前端传来的** → 记录表里的照度可信，改不了假。

**★ 工程约定**：以后给"已经交付/已提交"的系统加功能，一律用这套流程 ——
**复制副本 → 副本上改 → 副本上起服务测 → 全绿了再动原目录**。
本次两个产物可复用：`dataset\app_module\apply_to_app.py`（一键装 + 自动备份 + 回滚命令）、
`sync_verify.ps1`（工作库↔提交包哈希校验）。

**顺带修掉的一个仓库隐患**：编辑 `.ps1` 会丢掉 UTF-8 BOM，而 Windows PowerShell 5.1
按 GBK 解码无 BOM 的脚本 → 里面的中文路径（如 `D:\aic\aic AI+硬件`）变乱码、脚本直接失效。
已加 `ensure_utf8_bom.py`（全库扫描 .ps1/.bat，`--fix` 补 BOM），本次修复 1 个文件。

---

### 2.15 T-602 独立数据集采集台（2026-10-08，接口自测 12/12）✅

**目的**：把"采集样本"做成一个**自带页面的独立小工具**，它**不引用、也不修改任何已有软件**，
只依赖我们自己固件的串口协议。这样硬件侧的成果可以完全独立地交付与展示。

**与硬件的接口**（就是正式固件协议，非自造）：

| 命令 | 回复 |
|---|---|
| `STATUS` | `{"ok":true,"lux":123.4,"brightness":25,"result":"idle"}` |
| `LIGHT <0-100>` | 设置亮度并回一条 `STATUS` |
| `PING` | `{"ok":true,"device":"LIGHTGUARD_ESP32"}` |

**实测结果（`--no-serial` 无硬件模式 + 伪造串口两种场景）**：

| # | 测试 | 结果 |
|---|---|---|
| 1 | 首页 `GET /` | ✅ HTTP 200，页面自包含（无外部依赖） |
| 2 | `GET /api/status` | ✅ 6 个类别、默认亮度 25、硬件状态字段齐全 |
| 3 | `POST /api/capture` | ✅ `normal_0001.jpg` 落盘 + CSV 追加一行 |
| 4 | `GET /api/recent` | ✅ 返回文件名/类别/大小/时间 |
| 5 | `GET /api/thumb/<类>/<名>` | ✅ 200 且 `Content-Type: image/jpeg` |
| 6 | 目录穿越 `..%2F..%2Fapp.py` | ✅ 被拦（404），取不到源码 |
| 7 | 未知类别 / 合法名但不存在 | ✅ 400 / 404 各按预期 |
| 8 | 类别独立计数 | ✅ normal / scratch / stain 各自从 0001 起 |
| 9 | `POST /api/undo` | ✅ 图片与 CSV 那一行同步删除 |
| 10 | `POST /api/light`（未接硬件） | ✅ **HTTP 409 + 人话错误**（见下方修正） |
| 11 | 非法亮度（150、151） | ✅ HTTP 400 |
| 12 | `GET /api/export` | ✅ zip 内含 `images/` 与 `采集记录表.csv` |

**实测中修正的两处**：

| 问题 | 现象 | 修正 |
|---|---|---|
| 未接硬件时"假装成功" | 点"设为 25%"返回 `ok:true`，但灯带根本没动 —— 会误导现场操作 | 未连硬件时返回 **409 +「未连接硬件，灯带没动」**，前端显示错误 |
| 串口不存在时的降级 | 指定 `--port COM99` | ✅ 服务照常启动，日志明确报 `打开串口失败：could not open port 'COM99'`，采集功能不受影响（照度记空） |

**安全约定**：工具在**连上串口时**与**退出时**都会主动发 `LIGHT 0` 关灯。
（当时正式固件复位后默认亮度是 45%，所以这条规矩必须由工具兜住；该默认值已于 2026-10-09 改为 **0%** 并烧录验证 —— 见 §2.16.5，工具这一层保留为双保险。）

**说明**：存储逻辑 `dataset_manager.py` 与"可选接入模块"共用一份，就放在采集台目录内，
保证采集台**自身完整** —— 拷到任何装了 Python 的电脑都能跑。

**★ 评审口径**：这是硬件侧**独立可交付**的证据 —— 不需要任何已有软件在场，
一块 ESP32 + 一个摄像头就能复现整个采集流程。

---

### 2.16 T-701 硬件演示台（上位机软件）与真机联调（2026-10-09）✅

**目标**：交付一个**能用的上位机软件**，把硬件闭环演示完：稳光 → 采集 → 判定 → 红绿/声反馈 → 记录。

**组成**（`硬件演示系统/演示台/`，全部自带、不引用任何已有软件）：

| 文件 | 作用 |
|---|---|
| `hw_link.py` | 串口链路（PING / STATUS / LIGHT / RESULT），全程一把锁；连上串口与正常退出时都发 `LIGHT 0` |
| `light_loop.py` | 上位机照度闭环：比例控制 + 步长限幅 + **自动估算增益** + 死区 + 最小步长 |
| `detect_ref.py` | 参考图比对判定：对齐（粗搜+精修）+ 亮度归一化 + 边缘屏蔽 + 形态学去噪 |
| `demo_console.py` / `demo.html` | 页面与接口（稳光曲线、拍照判定、手动判定、记录表） |
| `test_detect_ref.py` | 判定模块自测（合成图，10 项全过） |

#### 2.16.1 照度标定（真机，正式固件，8 kHz PWM）

每档升亮后**等 2.5 秒**再连读 3 次取中位：

| 亮度% | 0 | 5 | 10 | 15 | 20 | 25 | 30 | 35 | 40 | 50 | 60 | 75 | 90 | 100 |
|---|---|---|---|---|---|---|---|---|---|---|---|---|---|---|
| **照度 lx** | 0.0 | 33.3 | 81.7 | 130.0 | 179.2 | 224.2 | 272.5 | 322.5 | 371.7 | 466.7 | 565.8 | 710.0 | 855.0 | 965.8 |

- 拟合（15%~100%）：**照度 ≈ 9.77 × 亮度% − 19.1**，即 **9.77 lx / 每 1%**
- ★ **达到 900 lx 需要 94.1% 亮度** —— 在**当前几何**下（传感器在桌面、离灯带较远），
  **900±30 lx 这个验收点与"相机不过曝"是冲突的**（相机实测 100% 已经过曝）。
- 相机安全区间 **20%~35%** 对应 **179~322 lx**。

**建议（需决策）**：要么把 BH1750 固定到**箱内最终位置**（离灯带更近）后重新标定 ——
那时 900 lx 可能只需 25%~35%；要么把验收点改成与相机匹配的值（如 300±30 lx）。
**"约 30% 亮度 ≈ 900 lx" 在本次几何下不成立**（那 28.5 lx/% 是另一种摆放测到的）。

#### 2.16.2 闭环实测（真机）

| 目标 | 过程 | 结果 | 用时 |
|---|---|---|---|
| 300 ± 20 lx | 25% → 223.3 lx（误差 76.7）→ 31% → 283.3 lx | ✅ 收敛（误差 16.7 ≤ 20） | **9.1 秒 / 2 次迭代** |

增益自动估算生效：未知几何时用默认 10 lx/%，与本次实测 9.77 吻合。

#### 2.16.3 判定 + 硬件反馈闭环（真机，用真实标签图案）

参考图 = 合格品 `label_normal.png`，逐个把 6 种图案当"待检"送进判定接口：

| 待检图案 | 判定 | 差异占比 | 串口回读的硬件指示 |
|---|---|---|---|
| label_normal | **正常** ✅ | 0.000% | `normal`（绿灯） |
| label_brokenline | **异常** ✅ | 0.326% | `abnormal`（红灯+蜂鸣） |
| label_faint | **异常** ✅ | 4.398% | `abnormal` |
| label_stain | **异常** ✅ | 0.633% | `abnormal` |
| label_scratch | **异常** ✅ | 0.425% | `abnormal` |
| label_offset | **异常** ✅ | 22.174% | `abnormal` |

**6/6 判对，且每次判定都真的改变了硬件指示**（不是只在网页上显示）。
参数校验：非法 value → 400；亮度 150 → 400；未接硬件时 `LIGHT` / `RESULT` → **409 + 人话错误**。

#### 2.16.4 实测中发现并修掉的问题

| # | 问题 | 现象 | 修正 |
|---|---|---|---|
| 1 | **读数方法错** | 升亮后 0.8 秒就读，得到 15%→12.5 lx、20%→163.3 lx 这种**非单调乱数** | 改亮度后 **等 2.2~2.5 秒**、连读 3 次取中位；此后 0%/25%/100% 三档极差仅 0.0~2.5 lx。纪律已写进 `light_loop.py` |
| 2 | 判定器对齐精度不够 | "整体平移 6,4 像素"被判成差异 **12.1%**（假报警） | 1/4 缩小图粗搜 + **原图 ±5 像素精修**；修后同场景差异 **0.000%** |
| 3 | 默认阈值太松 | 污点 0.69%、划痕 0.33% 都漏检 | 默认阈值 0.8% → **0.25%**（噪声/压缩/平移都是 0.000%，压得下来） |
| 4 | 画面边缘造成假报警 | 平移后边缘内容移进/移出，残留 1.4% 差异 | **边缘 12 像素不参与判定** |
| 5 | ★ **强杀进程不关灯** | 关窗口/任务管理器结束程序时 `finally` 不执行 → 不发 `LIGHT 0`；板子一旦复位就回到固件默认亮度（当时是 **45%**，实测回读 `brightness=45`、415 lx） | ① 固件**默认亮度 45 → 0**，**已烧录并验证**（见 2.16.5）；② 软件连上串口与正常退出时都发 `LIGHT 0`（双保险） |

---

### 2.17 T-702 演示/验收工具补齐（2026-10-09）✅

**目的**：把"现场演示"和"验收标定"这两件事变成**照着做就行**，而不是靠记忆。

| 工具（都在 `硬件演示系统/演示台/`） | 作用 | 关键设计 |
|---|---|---|
| `calibrate_lux.py` + `0_照度标定.bat` | 逐档升亮标定，拟合 lx/每1%，**自动判断是否与相机不过曝区间冲突**，导出 Markdown 报告 | 每档等 2.5 s、连读 3 次取中位（见 2.16.4 的教训）；结束必发 `LIGHT 0` |
| `light_off.py` + `关灯_应急.bat` | **应急关灯**：一条命令关灯，并**回读硬件确认**（不靠软件自称） | 用于"程序被强杀"或"板子刚复位"之后 |
| `banding_check.py` | 频闪条纹复测（关闭 §2.13 的待复测项） | **自动挑最平坦区域**再算行 σ（若 ROI 落在文字上，σ 反映的是字的明暗而非条纹）；过曝帧直接拒收；**抓帧默认测完删除**（`--keep` 才保留） |
| `现场演示检查单.md`（包内 `硬件演示系统/`） | 一页检查单：接线 → 上电 → 软件启动 → 演示四步 → 安全红线 → 故障速查 | 每项都写"看到什么才算对" |

**实测（真硬件）**：

| 项 | 结果 |
|---|---|
| 应急关灯工具 | ✅ 运行前回读 **亮度 45% / 405.8 lx**（说明"串口一开一关 → 板子复位 → 回到 45%"在真实使用中确实会发生），执行后回读 **0%** |
| 频闪复测（当前场景） | ⚠️ **不可用**：当前画面 25% 档整幅均值 254（**全白过曝**），50% 档 ROI 落在文字上 —— σ 反映的是纸面内容。**必须把相机对准空白纸/标签**后再跑，已在工具里写进运行前警示 |
| 三个新工具 | ✅ 语法检查通过；应急关灯已实跑验证 |

**★ 过程纪律（视觉项目通用，写进工具与检查单）**：
抓帧、录制、数据集采集前**先确认画面里没有个人材料**（证件、表格、聊天窗口等）；
本项目的抓帧工具**默认测完即删**，需要保留才加 `--keep`。

**待办**：
- ⏳ 8 kHz 频闪复测：等相机对准**空白纸或标签**后跑 `banding_check.py`（当前场景不成立）；
- ⏳ 最终几何照度标定：把 BH1750 固定到箱内最终位置后跑 `calibrate_lux.py`，用报告里的结论决定"900 lx 验收点"是否要改。

#### 2.17.1 抓拍图片规范化（同日追加）✅

**问题**：采集接口原来把上传的原始字节直接写成 `.jpg` —— 收到 PNG 也会存成 `.jpg`（扩展名与内容不一致），
而且**相机的 EXIF 元数据会被原样保留并随数据集交付出去**（可能含设备/时间等信息）。

**修正**：`demo_console.py` 增加 `_to_jpeg()`，所有进出的图片统一转成真正的 JPEG（RGB、质量 92）。
顺带把元数据丢掉 —— 数据集是要交付的，不该把相机元信息一起带出去。

**回归验证（真机 + 真实标签图案）**：6 种图案再次逐一判定，**6/6 判对**，
且串口回读的红绿指示每次都对；落盘图片经 Pillow 复核为 `format=JPEG`、`EXIF字段数=0`。

| 图案 | 判定 | 差异% | 硬件回读 |
|---|---|---|---|
| normal | 正常 ✅ | 0.000 | `normal` |
| stain | 异常 ✅ | 0.634 | `abnormal` |
| scratch | 异常 ✅ | 0.426 | `abnormal` |
| brokenline | 异常 ✅ | 0.326 | `abnormal` |
| faint | 异常 ✅ | 4.399 | `abnormal` |
| offset | 异常 ✅ | 22.151 | `abnormal` |

#### 2.17.2 ★ 串口一开一关就会复位板子（2026-10-09 实测，重要）

**现象**：连续两次运行 `light_off.py`，两次打印的"关灯前"都是 **亮度 45%**（415 / 408 / 405 lx），
而上一次运行结束时的回读明明是 **0%**。

**结论**：这块板（CP2102 + 部分自动复位电路）**每次串口会话结束、端口关闭时都会复位一次**，
复位后固件按默认值启动 → 老固件是 45%，所以灯又亮了。

**这意味着**：
- 上位机软件里"退出时发 `LIGHT 0`"**保证不了最终状态** —— 端口一关，板子又复位；
- 唯一的根本解法是**固件默认亮度 = 0** —— **已于 2026-10-09 烧录生效并实测验证**（见 2.16.5）：
  现在复位后回读 `brightness=0`，端口开关都不会再让灯亮；
- 烧录之前那段时间，现场收尾只能靠 `关灯_应急.bat` 手动关、或拔掉灯带 5V 适配器。

**过程纪律**：任何"读串口"的动作（包括我们自己排查）都会让板子复位一次；
在老固件时代这意味着"排查完必须补一次 `LIGHT 0`"。**现在固件默认 0%，复位不再点亮灯带**，
但这条纪律仍然值得保留 —— 因为如果之前手动把亮度调上去了，复位不会替你关灯（它只是回到 0% 并重新启动）。

#### 2.16.5 烧录"默认亮度 0%"的固件 ✅（2026-10-09 已完成并验证）

**过程**：

1. 本轮先发现 **ESP32 开发板支持包被删除**（`arduino-cli core list` → `No platforms installed`，
   `Arduino15\packages` 为空）。第一次重装卡住 —— **根因是我给安装带上了坏代理**
   （`HTTP(S)_PROXY=127.0.0.1:7897` 对 github 不通）；去掉代理后直连约 **2.5 MB/s**，
   `esp32:esp32@3.3.12` 安装成功（含各芯片库，约 4 GB）。
2. 编译正式固件通过：**307,619 字节（占 23%）**。
3. 烧录：自动进下载模式**不行**（`Wrong boot mode detected (0x13)`，与既有记录一致）→
   必须手动按 BOOT。使用 `flash_manual.ps1 -Baud 115200`，要求用户按
   **按住 BOOT → 点一下 EN → 松 BOOT**。
4. 结果：**4 个镜像全部写入，逐个 `Hash of data verified`**，随后 `Hard resetting via RTS pin...`。

**烧录后的验证（关键）**：

| 项 | 结果 |
|---|---|
| 复位后立刻读（打开串口即复位） | `{"ok":true,"lux":0.0,"brightness":0,"result":"idle"}` → ★ **默认亮度 = 0% 生效**（老固件此处必然是 45%） |
| 调光回归 `LIGHT 25` | 回读 25%，照度 **222.5 lx**（与标定曲线 25%≈224 lx 吻合） |
| 关灯 `LIGHT 0` | 回读 0% ✅ |

**结论**：`串口一开一关就复位 → 灯又亮到 45%` 这个反复出现的现象**根除**；
上位机的"退出关灯"从此只是双保险，而不再是唯一手段。

**★ 交付口径**：演示台是**独立可用的上位机软件** —— 一块 ESP32 + 一个 USB 摄像头，
双击一个 `.bat` 就能跑完"自动稳光 → 拍照 → 判定 → 硬件亮灯"的完整闭环；
其自带判定是**参考图比对**（轻量、可解释、带差异图），
**不是**替换作品里的 PatchCore 异常检测模型（那属另一套系统，本软件不引用也不修改）。

---

### 2.18 T-703 频闪条纹复测（**关闭 §2.13 待复测项**）+ 相机曝光区间实测 ✅（2026-10-09）

**背景**：§2.13 把 PWM 从 1 kHz 提到 8 kHz 抑制相机画面条纹，但**当时没有按同一方法复测**，
一直是验证记录里挂着的"已改代码、未复测"。本轮相机对准**标签**后补测。

**方法（与 1 kHz 那次一致）**：串口设亮度 → 等稳定 → ffmpeg 抓 5 帧取最后一帧 →
在画面里自动挑**最平坦区域** → 逐行灰度均值求标准差 σ。

| 亮度% | 整幅均值 | ROI 均值 | 过曝像素占比 | **行 σ** | 判定 |
|---|---|---|---|---|---|
| 0 | 1.0 | 1.0 | 0.0% | 0.00 | 灯灭（基线） |
| 15 | 175.0 | 241.6 | 0.5% | 0.94 | 条纹很弱 ✅ |
| 20 | 174.4 | 242.5 | 0.4% | 0.74 | 条纹很弱 ✅ |
| 25 | 169.2 | 236.2 | 0.1% | **0.65** | 条纹很弱 ✅ |
| 30 | 170.5 | 235.4 | 0.1% | 0.53 | 条纹很弱 ✅ |
| 35 | 167.9 | 233.7 | 0.1% | 0.54 | 条纹很弱 ✅ |

**结论①（关闭 §2.13）**：8 kHz 下同一 ROI 方法的行 σ 为 **0.50~0.94**，
对比 1 kHz 时代同亮度（25%）的 **8.85 / 8.78 / 8.80**，**降低约 16 倍** → **条纹基本消失**。
> 口径说明：两次场景不同（1 kHz 那次在纸箱内对着纸面，这次在桌面对着标签），
> 但曝光水平相近（ROI 均值 168 vs 236，这次更亮却条纹更弱），方法与亮度点相同，结论方向一致。

**结论②（对采集数据集同样重要）**：这套光照下**相机自动曝光收敛慢、低亮度段不可靠**：

- **≤10%**：不稳定 —— 实测同一档位在"等 2.5 秒"与"等 6.5 秒"两种等待下结论相反
  （5% 时 96.5% 像素过曝 ↔ 均值只有 25 的偏暗画面；10% 时 24%~65% 像素过曝）；
- **15%~35%**：稳定（整幅均值 168~175、过曝像素 <0.5%、σ <1）。

**★ 工程约定（写进采集流程）**：
1. 采集/演示用 **20%~30%** 亮度；
2. **改完亮度后等 5~7 秒再拍第一张**（要等相机自动曝光收敛，不只是等照度稳定）；
3. 每档测条纹之前也要等够，否则测到的 σ 是"曝光还没收敛"的产物，不是条纹。

**工具**：`硬件演示系统/演示台/banding_check.py`（`--settle` 可调等待、过曝比例判定、抓帧默认删除）。

---

### 2.19 T-704 取景体检 + 真实相机帧的误报验证（2026-10-09）✅

**背景**：用户把打印好的标签放到相机下方（整张 A4，未裁开）。趁这个机会做两件以前做不了的事：
① 用**真实相机帧**（不是设计源图）验证判定阈值会不会误报；② 体检取景与光照是否满足采集要求。

**工具**：`硬件演示系统/演示台/check_framing_and_fp.py`
（设亮度 → **等 7 秒**让相机自动曝光收敛 → 抓两帧 → 逐项体检；抓帧跑完即删）

#### 2.19.1 误报验证（最关键）✅

同一张标签的**两帧真实相机照片**互相比对（一帧当参考图、一帧当待检），结果：

| 指标 | 实测 | 判断 |
|---|---|---|
| 判定 | **正常** | ✅ 不误报 |
| 差异占比 | **0.000%**（阈值 0.25%） | ✅ 余量充足 |
| 相似度 | **99.51%** | ✅ |
| 对齐偏移 | [0, 0] | ✅ 机位稳定 |

→ **真实相机的 JPEG 噪声 + 自动曝光微漂移不会让 0.25% 的阈值误报**，可直接用于采集与演示。
（此前 §2.16.3 的 6/6 验证用的是设计源图；这次补上了"真实相机帧"这一环。）

#### 2.19.2 取景与光照体检

| 项 | 实测 | 结论 |
|---|---|---|
| 画面里可见标签 | 完整 **11** 个 + 贴边被裁 **3** 个 | 整张 A4 一图可用（换纸即换样品） |
| 单个标签占画面 | **7.0%**（约 460×310 px），长宽比 1.45（设计 1.50） | 缺陷仍可检出（划痕 0.4% 差异），但若想"一图一标签"应拉近到 40%~70% |
| 纸面亮度（90 分位） | **215** | 合适（理想 200~235）✅ |
| 墨色亮度 / 对比度 | 45 / **170** | 对比度很好 ✅ |
| 过曝像素占比 | **0.00%** | 不过曝 ✅ |
| 四象限均值 | 左上 122.9、左下 124.3、**右上 176.7、右下 179.9** | ⚠️ **左右差 54.7 灰度（约 30%）**：右边亮、左边暗 |
| 清晰度（拉普拉斯方差） | 141 | 对焦可用 |

**★ 由 2.19.2 得出的采集约定**：

1. **左右光照不均 30%** 意味着：**如果把标签在画面里换位置放，参考图比对会把它误判成缺陷**。
   所以二选一：
   - **整张纸固定不动、只换纸**（推荐，当前取景就是这个用法）；或
   - 先把光照调匀（灯带居中/加柔光/拉高距离），再用本工具复测到左右差 <25 灰阶。
2. 左边暗意味着**左侧标签的缺墨/划痕对比度更低**，采集时优先用靠中间/右侧的标签。
3. `check_framing_and_fp.py` 已加入"像标签的矩形"识别（长宽比 1.2~1.9 先验）——
   第一版实现用"最大暗块"，实测把画面左侧的背景暗区误判成标签（报"贴边、只占 12.8%"），
   改成形状先验后才得到正确结论（完整 11 个、单个占 7.0%）。

---

### 2.20 T-705 "左暗右亮"归因：房间无环境光，光照完全由灯带决定（2026-10-09）✅

**问题**：相机画面里纸面左侧明显比右侧暗（外侧 1/3 相差 45 灰阶），连续三次调整后数字几乎不变
（45.4 → 45.5 → 45.8），于是做了一次**归因实验**：把灯带关掉，看这个亮度差还在不在。

**工具**：`硬件演示系统/演示台/diag_light_source.py`（开关灯各抓一帧，**用同一套纸面掩膜**对比左右）

| 条件 | 纸面左 | 纸面右 | 左右差 | 整幅均值 |
|---|---|---|---|---|
| 灯带 **0%**（只有环境光） | 0.7 | 0.9 | **0.1** | **1.0**（几乎全黑） |
| 灯带 **25%** | 185.9 | 205.1 | **19.2** | 145.5 |

**结论（两个都很重要）**：

1. **实验环境没有环境光**：灯带关掉时整幅均值只有 1.0 —— 也就是说光照**100% 来自灯带**。
   - 对采集是**好消息**：没有窗户/顶灯干扰，光照条件纯净、可复现；
   - 也说明"左暗右亮"**只能**是灯带的位置/高度造成的，挪灯带必然有效（此前我怀疑"可能是房间光"，被这个实验否掉）。
2. **差值的形态**：按"左右两半"算是 19.2 灰阶，按"最外两个 1/3"算是 45 灰阶 ——
   说明**差异集中在纸的最左边一条**（那一带被灯带以很小的角度掠过、基本照不到），
   对应的物理状态是"灯带偏右、且离纸面太近"。

**处置建议**：灯带**往左挪到纸中线正上方** + **抬高 15~25 cm**（抬高比左右挪更治本）。
**但注意**：只要"整张纸固定不动、只换纸"，这个不均匀**不会造成误判** ——
误报检查始终是 `差异 0.000% / 判正常`（§2.19.1）。所以调匀是"让左边那列也看得清"，不是必须项。

**顺带记录（影响采集节奏）**：这一轮实测到**相机自动曝光从 254 收敛到 145 需要 5 帧、约 12 秒**
（开灯瞬间画面一片白，要等明显超过 7 秒）。所以采集/演示**开灯后不要马上拍第一张**。

---

## 3. 最终任务清单（与用户给的清单一致）

- [x] ESP32 能识别 COM 端口（COM5 / CP210x）
- [x] Blink 上传成功（4 个镜像 Hash 校验通过）
- [x] 板载 LED 能按固定周期闪烁（500ms，串口同步印证）
- [x] BH1750 能读照度（0～约1442 lx 动态响应正常，I2C 0x23）
- [x] PWM 能调节灯带（亮度随 `BRIGHTNESS:` 变化，人工目视确认；正式固件 `LIGHT n` 通道尚未实测——正式固件未编译烧录）
- [x] 红绿指示逻辑正常（绿灯=正常 / 红灯=异常 / 异常短鸣，人工确认）
- [x] 照度闭环：自动调亮度锁定目标照度，稳态偏差 ≤1.4%（三段阶跃实测；**在验证固件 `light_pwm_test` MODE=1 与上位机 Python 上实测，正式固件尚未移植闭环，只有手动 `LIGHT n`**；实测目标 901/1472/2327 lx，未在 900 lx 验收点复测）
- [ ] 摄像头能稳定采图
- [ ] 纸箱内部光照均匀
- [ ] 正常样本检测为正常
- [ ] 缺陷样本检测为异常
- [ ] 串口协议跑通
- [ ] 硬件演示库整理完成（目录已建，固件与文档已就位）
- [ ] 录制完整演示视频
- [ ] 更新演示文档
- [ ] 最后再部署在线 AI 后端

---

## 4. 待办与风险提示

| # | 事项 | 说明 |
|---|---|---|
| 1 | 下次接线前先断电 | 带电插拔 I2C / 灯带容易打坏模块 |
| 2 | 灯带电源与 ESP32 必须共地 | 不共地 = PWM 完全失控（常亮或乱闪） |
| 3 | MOSFET 选逻辑电平型号 | IRF520 在 5V 下会发烫，别用 |
| 4 | BH1750 用 3V3 | 不要接 5V |
| 5 | 每次烧录都要按 BOOT | 本板无自动下载电路，属正常现象 |
| 6 | 不要用 GPIO6~11 / 34~39 | 前者接 Flash 会无法启动，后者只能输入 |
| 7 | **`.ps1` 必须带 UTF-8 BOM** | Windows PowerShell 5.1 按 GBK 解码无 BOM 的脚本 → 脚本里的中文路径变乱码、直接失效。改完脚本用 `py -3.11 ensure_utf8_bom.py --fix` 扫一遍 |
| 8 | **读中文文件要显式 `-Encoding UTF8`** | PS 5.1 的 `Get-Content` 默认按 GBK 解码，会把"GBK 前导字节 + 0x0A"当成一个双字节字符吃掉 → **静默丢行**。实测 `app.py`（699 行 / UTF-8）用默认编码读出来只有 **659 行**，差 40 行且不报任何错。要用行数/内容做判断时一律加 `-Encoding UTF8`，或直接用 Python 复核 |
