SHY10086332/lightguard-hardware/(commit log)

2026-10-08 初始化 LIGHTGUARD 硬件系统（ESP32 光照闭环 + 数据集生产线）
    - 01_ESP32固件：正式固件 lightguard_esp32.ino + 5 个外设验证固件 + 一键烧录脚本
    （PWM 提高到 8 kHz 以抑制相机画面的频闪条纹）
    - 02_硬件安装与接线：接线图 / 引脚表 / 一页速查卡 / 安装核对单
    - 03_采购清单：最低成本采购清单
    - 04_硬件验证记录：逐项实测原始记录（esptool 镜像 Hash 校验、BH1750 读数、
    PWM 调光、照度闭环 -1.4%、频闪量化、红绿指示与蜂鸣器）
    - 05_数据集与标签设计：6 类标签图案与 A4 打印页（60x40mm，18 个/页，100mm 校验尺）
    + 独立数据集采集台（Flask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
2026-10-08 补上仓库首页 README.md（首次提交时被镜像清理误删）
2026-10-08 补充独立数据集采集台：README 章节、实测记录 §2.15、提交说明索引
2026-10-09 新增硬件演示台（上位机软件）：闭环稳光 + 拍照判定 + 硬件反馈；补真机标定与联调记录
2026-10-09 新增可打印标签 PDF（6 页 A4，含 100mm 校验尺）与生成脚本 make_print_pdf.py
2026-10-09 补齐演示/验收工具：照度标定、应急关灯、频闪复测；新增现场演示检查单；修正固件默认亮度为0
2026-10-09 文档更新：打印改用 PDF、演示台工具说明、视频脚本指向现场检查单
2026-10-09 抓拍图片统一转真 JPEG 并清除 EXIF 元数据；补最终回归记录
2026-10-09 记录重要现象：串口开关即复位板子，退出关灯保证不了最终状态（根因需固件默认亮度=0）
2026-10-09 批处理统一 CRLF 换行
2026-10-09 演示台新增一键自检（串口/照度/灯带可控/参考图/输出目录/阈值），文档同步
2026-10-09 固件默认亮度=0 已烧录验证；全文更新所有过时的 45% 说明
2026-10-09 补一处漏改的默认亮度说明
2026-10-09 频闪复测完成（σ 8.8→0.5，关闭 §2.13 待复测项）；新增相机曝光区间与收敛等待的实测约定
2026-10-09 新增取景/光照体检与真实帧误报验证工具；记录左右光照不均 30% 与采集约定
2026-10-09 新增 hold_light.py（保持点灯，串口不断开）；关灯工具支持串口被占用时通过旗标请求持灯方关灯
2026-10-09 归因实验：房间无环境光、光照100%来自灯带；新增 diag_light_source.py；记录自动曝光需约12秒收敛
2026-10-09 采集台新增「一图一标签」自动裁切模式：只保留完整标签、剔除被画面裁掉的；含裁切预览与独立自测
2026-10-09 采集台支持只保留指定列（列筛选）+列亮度标注；新增界面截图并写进 README；页面支持 ?autocam=1
2026-10-09 新增两套演示视频拍摄脚本（硬件版完整分镜 + 软件版），含规格/分镜表/拍摄技巧/匿名红线/口径清单
2026-10-09 新增数据集材料：数据集说明书 + split_dataset.py（按样品划分、缺陷不进 train/good，含统计报告）
2026-10-09 新增 import_photos.py（手机照片自动裁成一图一标签并入库）+ 采集台支持按个数自动保留列
